aline-vernier/octo-laser/README.md

octo-laser
==========

Compression Chamber Design
