aline-vernier/octo-laser/HCF/Tamas Drawings.pdf

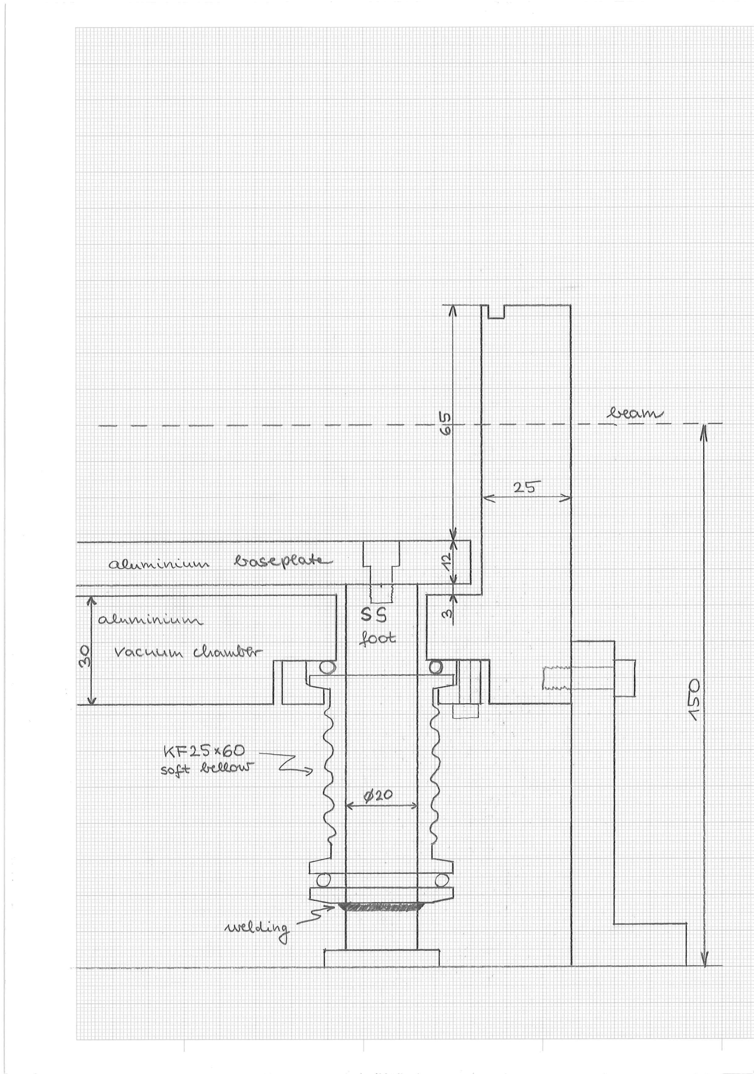
[picture p1: page 1]
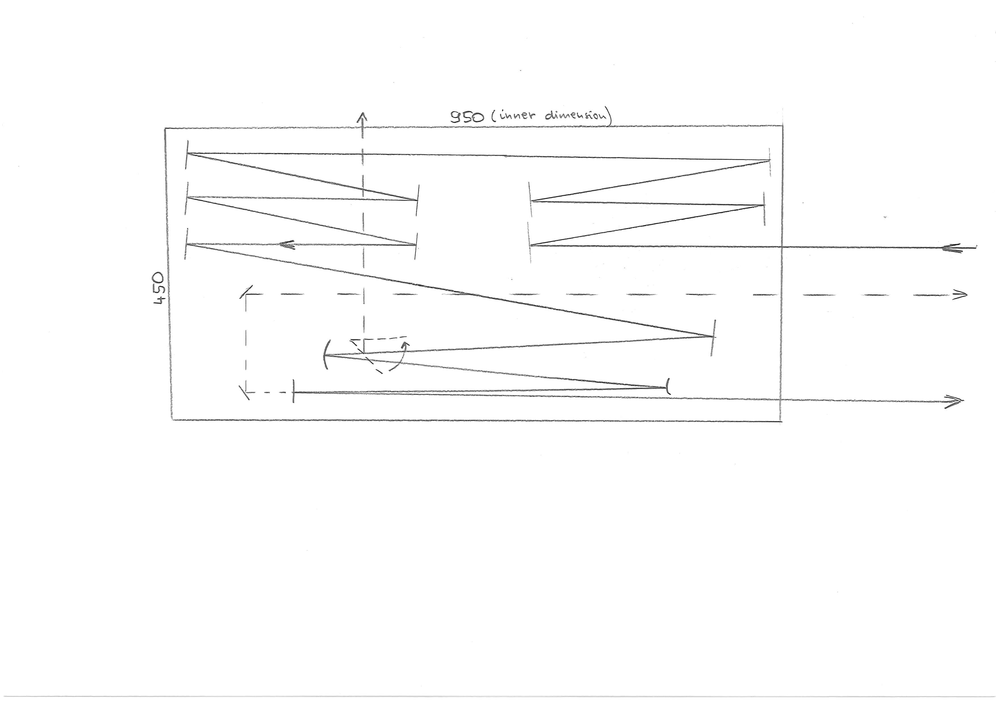
[picture p2: page 2]
