aline-vernier/octo-laser/HCF/Aurelie1.png

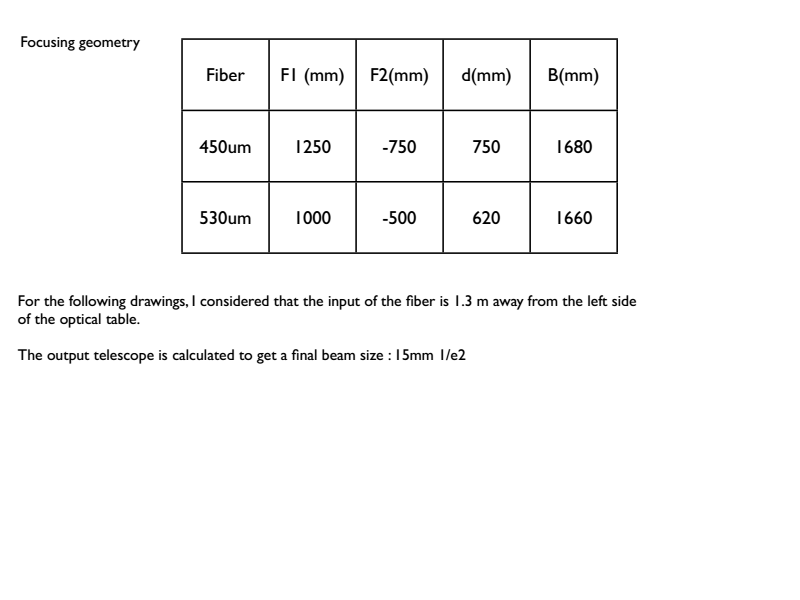
HCF/Aurelie1.png
