aline-vernier/octo-laser/HCF/Aurelie2.png

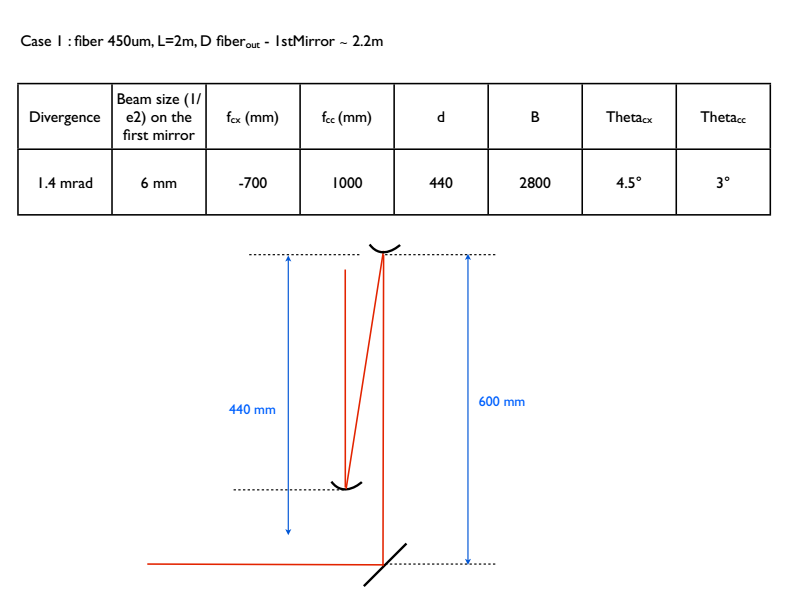
HCF/Aurelie2.png
