aline-vernier/octo-laser/HCF/Aurelie4.png

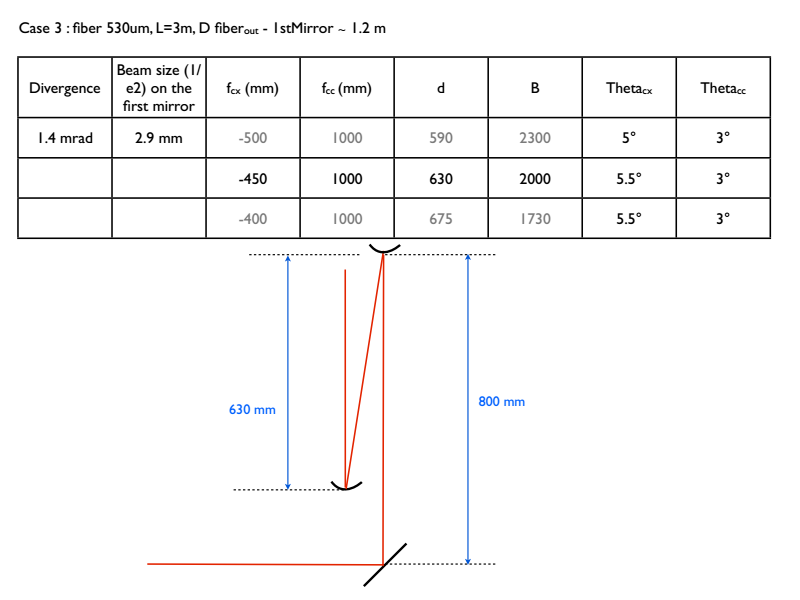
HCF/Aurelie4.png
