aline-vernier/octo-laser/HCF/Table Dimensions.png

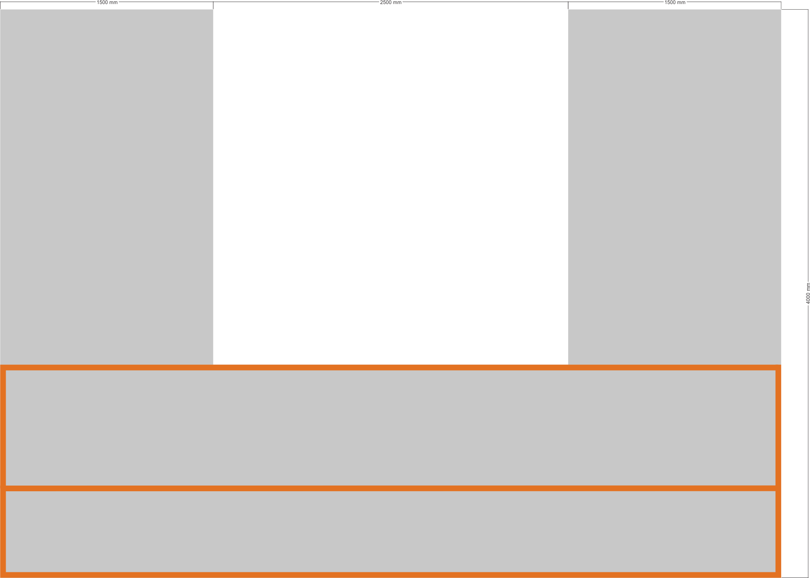
HCF/Table Dimensions.png
