aline-vernier/octo-laser/Mechanical_Electrical parts.rtf

Electrical Feedthroughs:

USB 3
SubD 15 1
SubD 25 4
SubD 9 3? (picomotors)

Machined flanges:

USB x2 + subD 15 x1 DN100
SubD25 Rosace
SubD9 x3 DN100

Brewster window DN100?
FROG window
CEP window
SH window

Motors:

Wedges - 2 motors:
-rotation
-translation
Mirror direction correction pulse-front tilt:
-translation

Picomotors:

HeNe x2
Main Beam x2
Correction beam direction après PFT x2
Correction Prepulse direction x2
