aline-vernier/octo-laser/Purchase List.xlsx

Description | Comment | Quantity | Distributor | Status
Periscope |  |  |  | Design not started
Periscope Main Beam |  |  |  | ?
Ground Plate for CMs |  |  |  | ?
Holed Mirror Translation | Frederik | 1 |  | Greg will do a design FB
Mount for 'Swiss Cheese' mirror | Aline | 1 |  | Designed, CAD in progress at Greg's
Plate for chirped mirrors |  |  |  | ?
Filter ( Lanex) |  | 1 |  | Found
TL Silver Mirror 3" |  | 4 | direct | ?
TL Silver Mirror 2" |  | 4 | direct | ?
TL Silver Mirror 1" |  | 4 | direct | Received 01/03/2015 FB
Mount 3" |  | Verify stock + check with Benoit for what has already been ordered | Newport | ?
Femtolasers Silver Mirror 1.5" |  | 4 | BFI | Ordered 01/03/2015 FB
1.5" mirror mounts |  | 4 | ? | ?
Window Flange |  | Verify stock |  | ?
Shack-Hartmann windows |  |  |  | Received (16/04/2015), Aurélie
Ceramic Plates | Beamblocking | 10 |  | Received glass diffusers OK? FB
Translation/flip for Beam block |  | 1 |  | Not designed
Pico Mount 3" | Compatible for our vacuum | 1 |  | Ordered 12/03/2015
Pico Mount 1" | Compatible for our vacuum | 1 |  | 2" Ordered 12/03/2015
ISO-K Tee + 2 Flanges | ISO 160 - | 1 |  | Received - Machining in progress
Vacuum-compatible subd 15 cable | 3 metres | 1 |  | Ordered on 29/01/2015, where is it?? To be reordered?
Shutter connector | Do we have everything? |  |  | Not done
Conformité ligne PI | Is the performance of the translation stage up to specs? |  |  | Not done
Add wedge to attenuator design |  |  |  | ok
New attenuator design test |  |  |  | ok, 160µrad PV over 4cm
2" Wedges for measurement |  |  |  | Ordered on 24/02/2015 (Aurélie)
More 3" Femtolaser/Layertec mirrors? |  |  |  | ?
99% transmission mirrors for far-field? (2") |  |  |  | ?
How many Newport flips + controllers do we have? |  |  |  | ?
Standalone picomotors to put on SH mirror x2 |  | 2 + controller |  | Not ordered
Feedthroughs for delay line (subd15 + HD subd15?) |  |  |  | Subd15 ok HD to be ordered
