aline-vernier/octo-laser/Shutter.FCStd

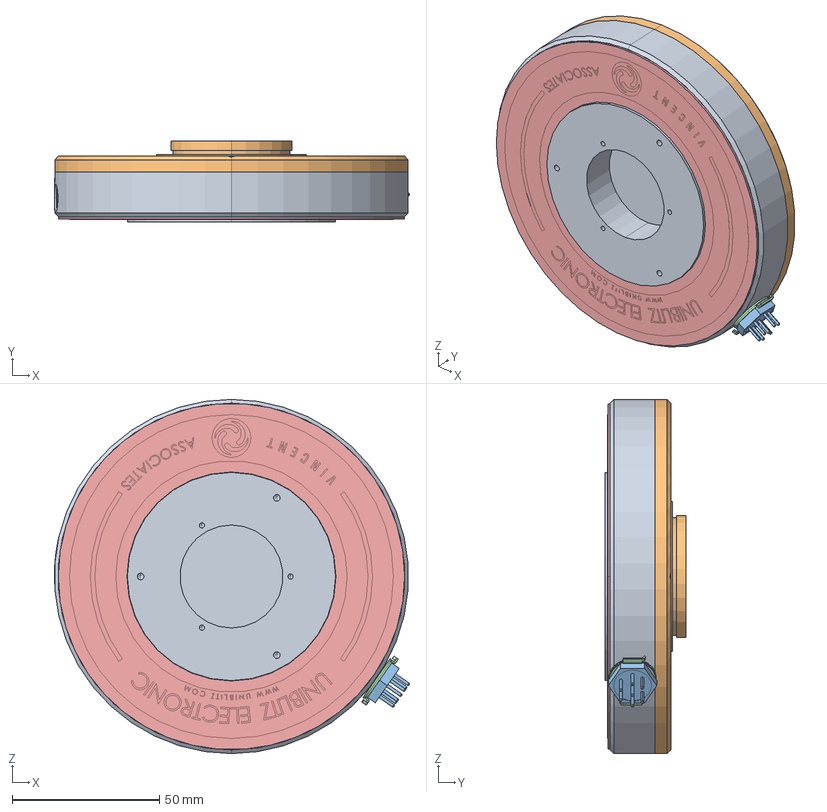
[picture p7: CAD file, 2014-10-17, last stored version]
Shutter.FCStd
120.4 x 27.3 x 120.1 mm
VS35 HOUSE dumb
VS35 HOUSE dumb001
VS35 HOUSE dumb002
VS35 HOUSE dumb003
VS35 HOUSE dumb004
VS35 HOUSE dumb005
VS35 HOUSE dumb006
VS35 HOUSE dumb007
VS35 HOUSE dumb008
