aline-vernier/octo-laser/ILAO40.stp

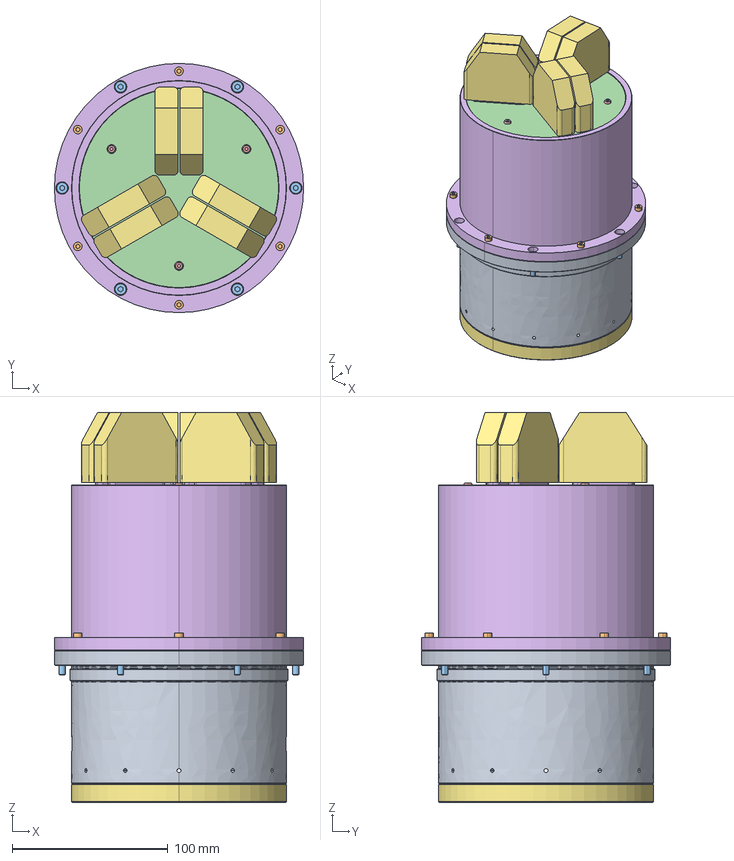
[picture p8: CAD file, 2014-10-06, last stored version]
ILAO40.stp
160.0 x 160.0 x 250.4 mm
VIS_CHC_M2-5_6 x 6
VIS_CHC_M3_12 x 6
VIS_CHC_M3_16 x 6
VIS_CHC_M4_16 x 6
OUTILLAGE_VISSAGE_ASM
VIS_CBC_M3_8 x 3
SUBD25 x 6
