aline-vernier/octo-laser/Salle Noire 2.1.pdf

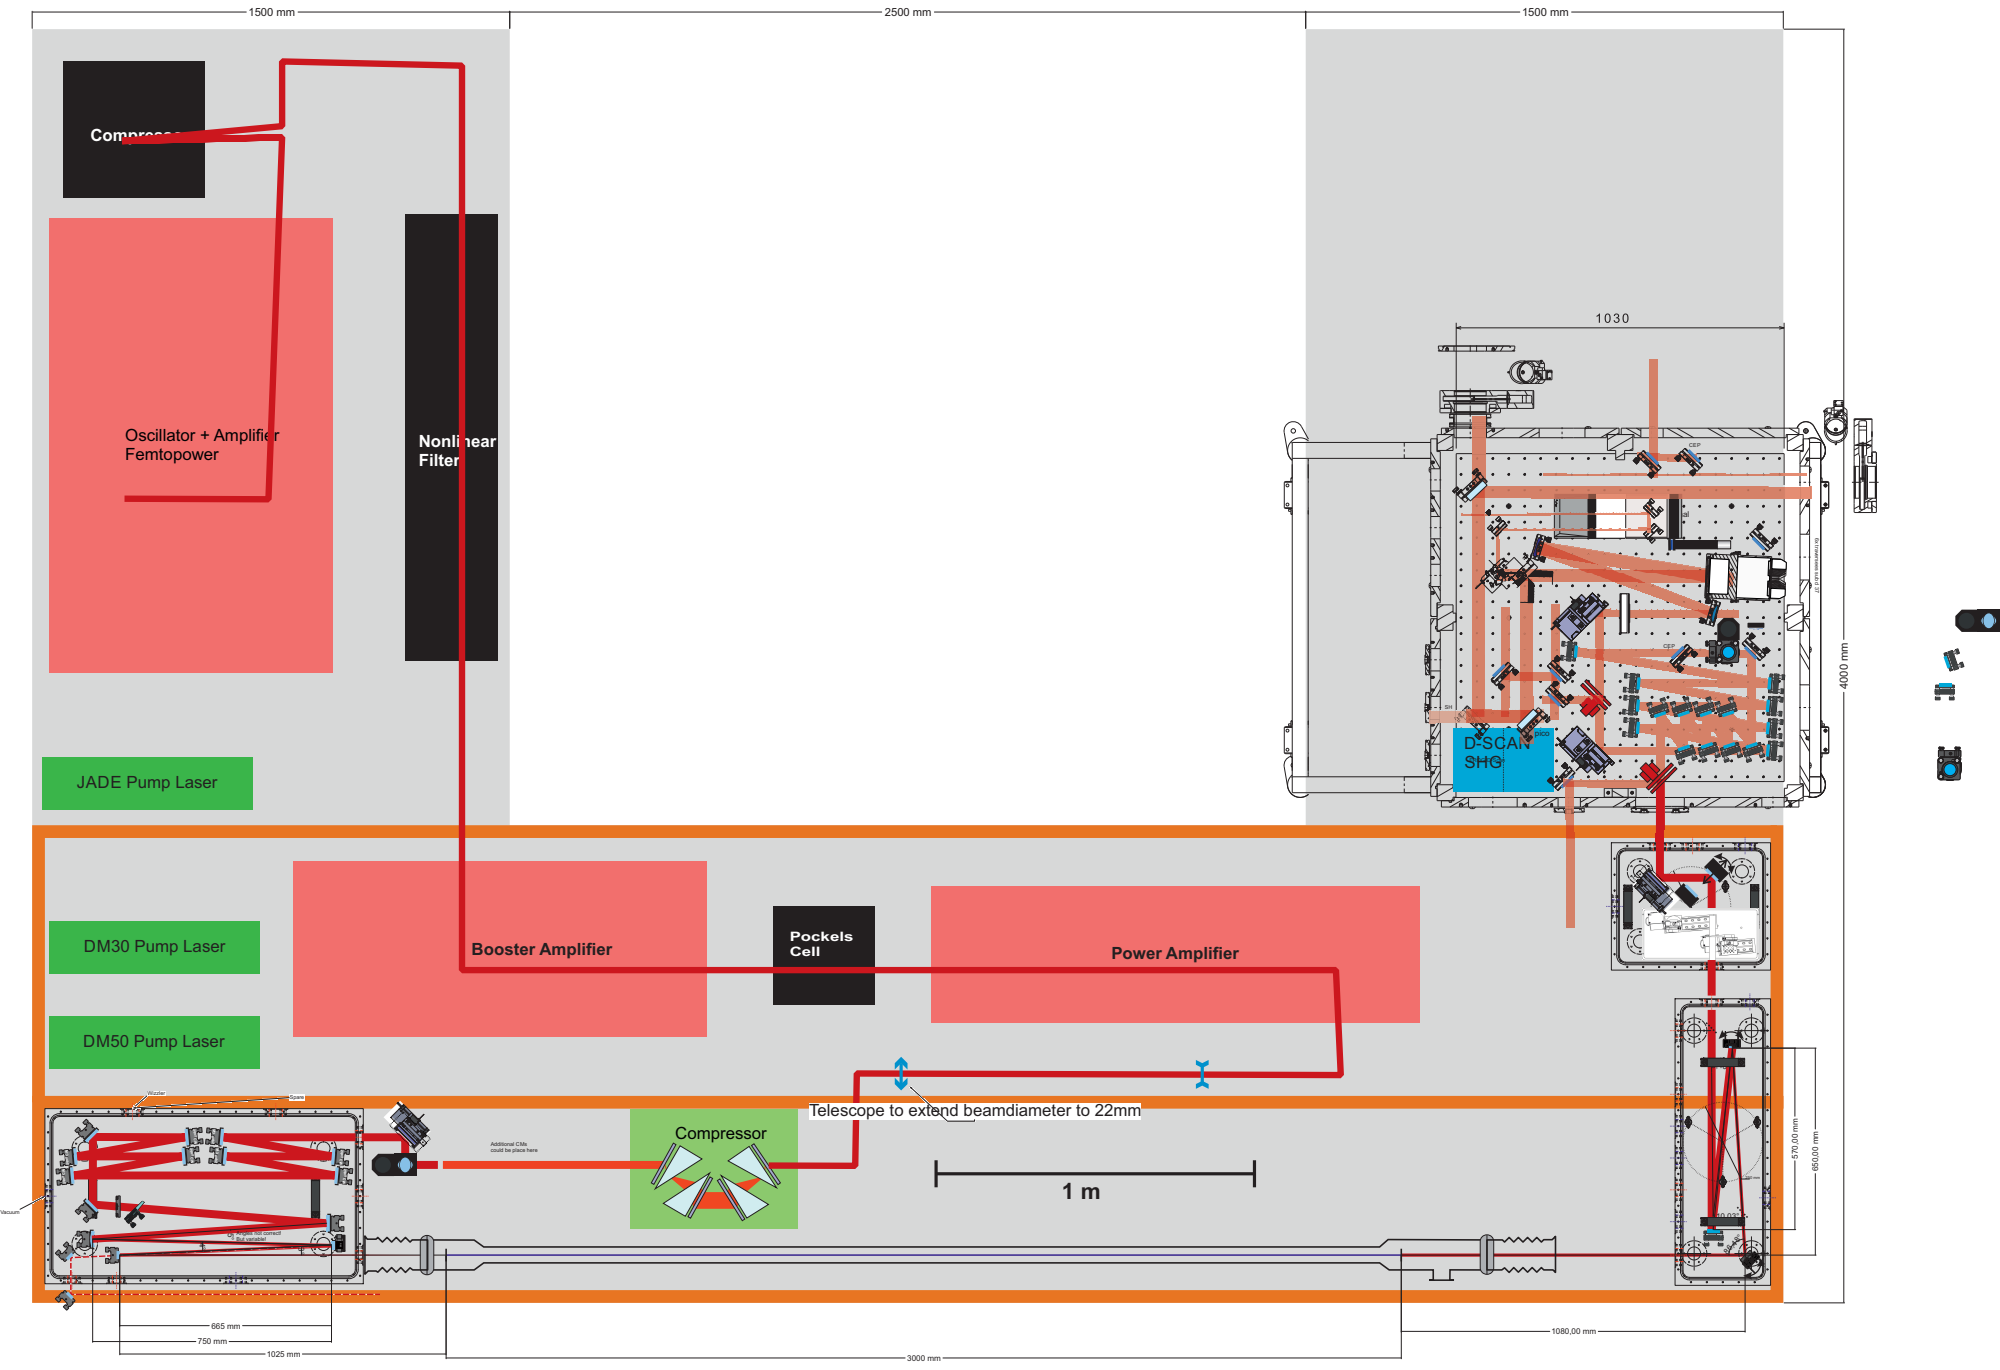
[picture p9: page 1]
Booster Amplifier; DM30 Pump Laser; DM50 Pump Laser; Power Amplifier; Oscillator + Amplifier Femtopower; Compressor; Nonlinear Filter; Pockels Cell; Vacuum; Wizzler; Spare; PIEZ; 5deg CM; 5deg C; D-SCAN SHG; 6x traversees sub d 37; pico; CEP; FROG/D-Scan

Location not final

JADE Pump Laser

Telescope to extend beamdiameter to 22mm

Additional CMs
could be place here

Angles not correct!
But variable!

555,00 mm
