aline-vernier/octo-laser/HCF/HCF Chambers Tamas/InputChamber-LOA_p2.pdf

A ( 1:2 )

A

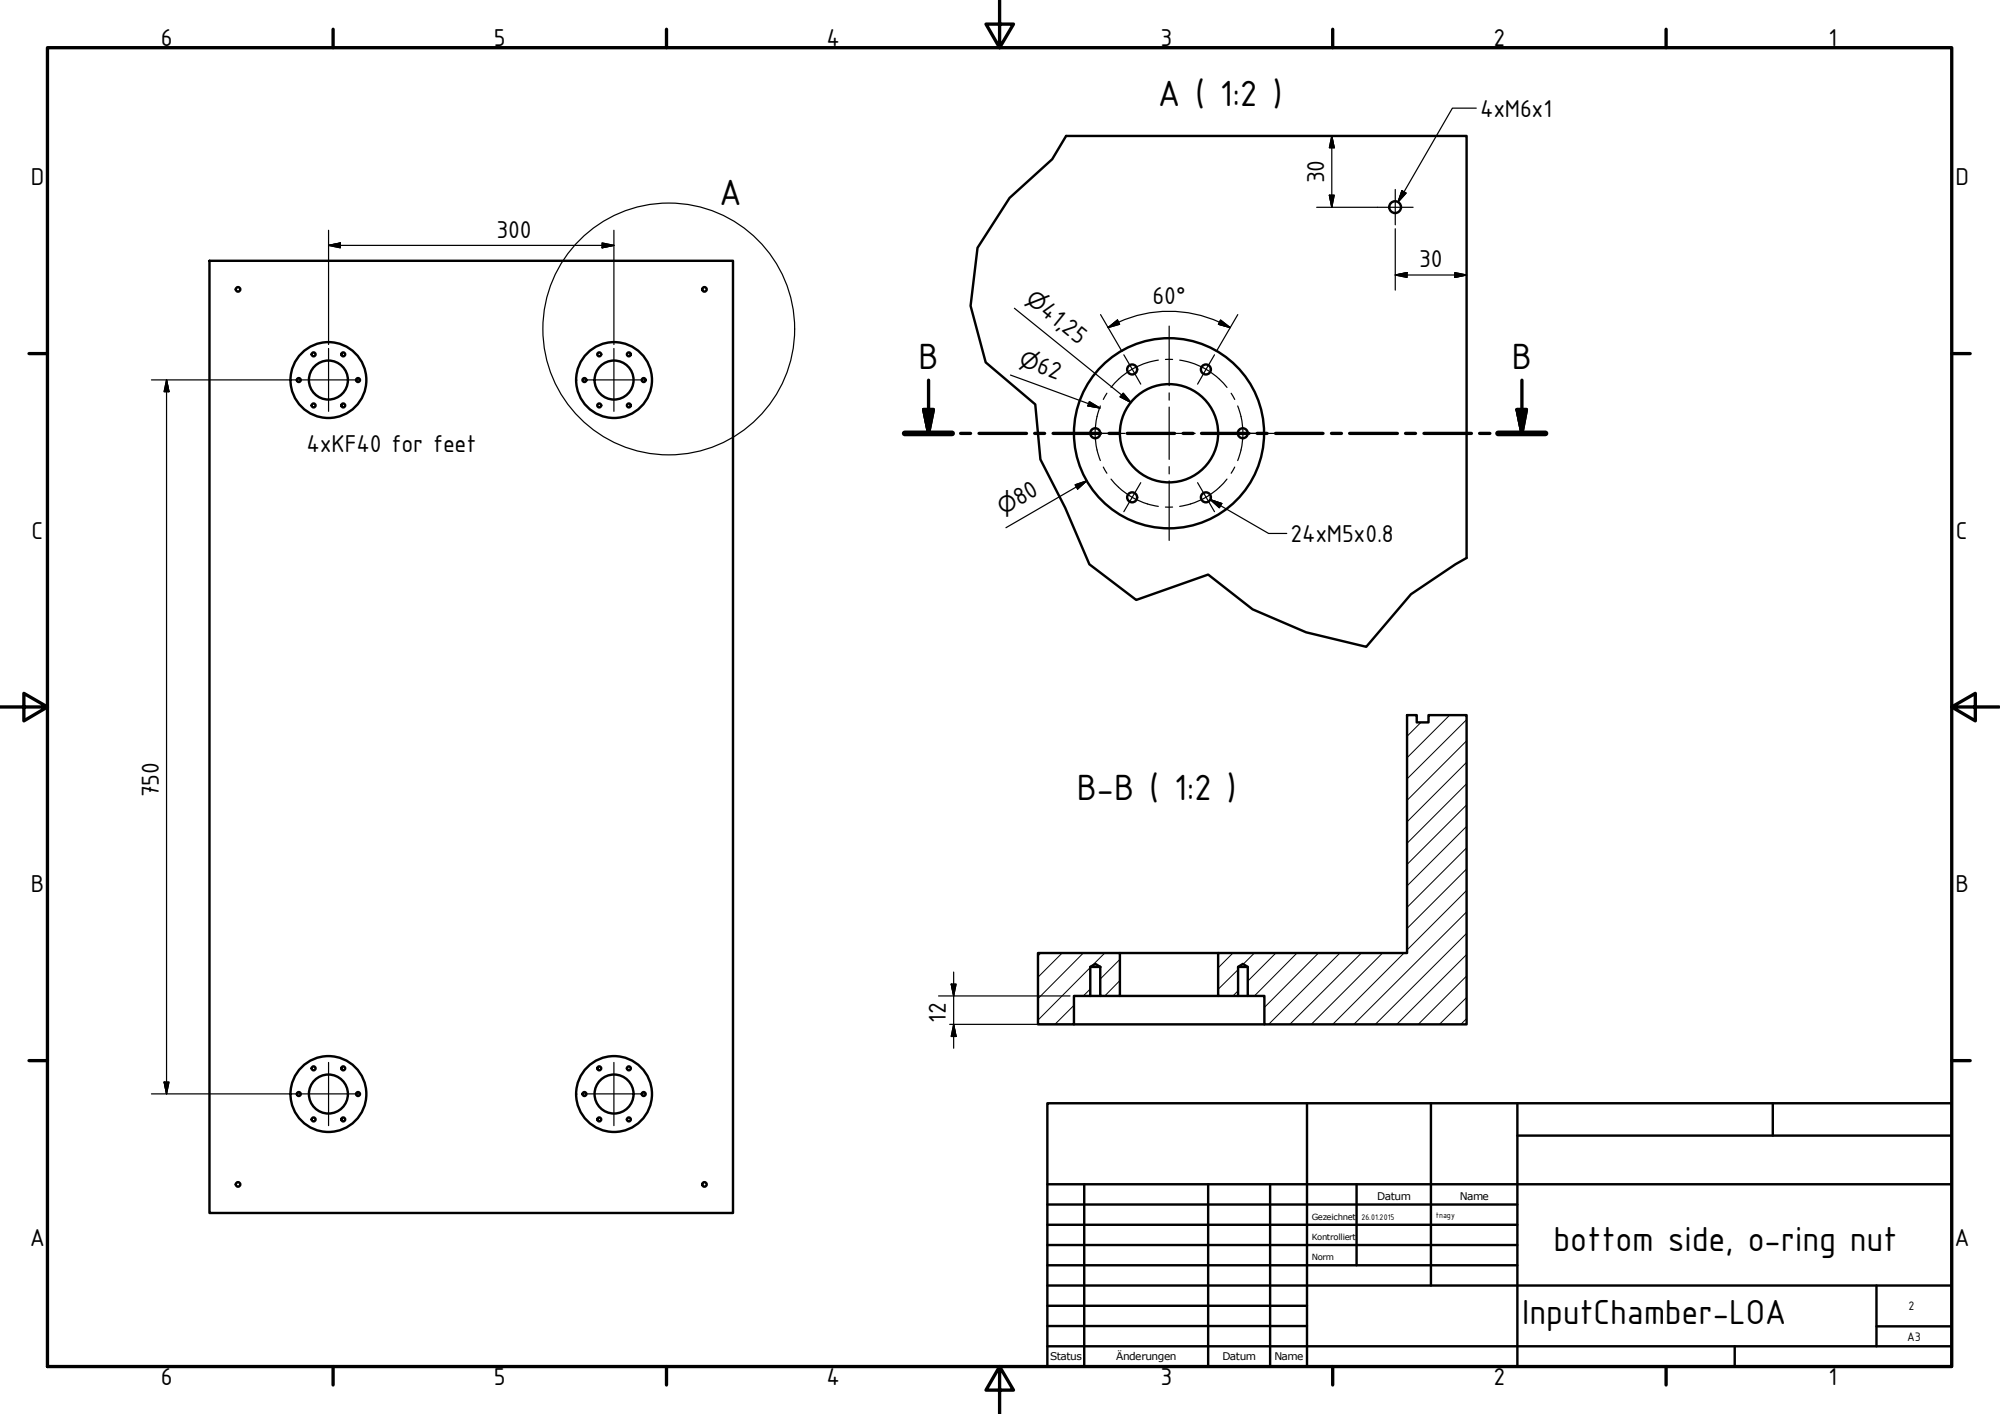
[picture p10: page 1]
InputChamber-LOA; Status; bnderungen; Datum; Name; Gezeichnet; Kontrolliert; Norm; tnagy; 4xKF40 for feet

bottom side, o-ring nut
