aline-vernier/octo-laser/HCF/HCF Chambers Tamas/OutputChamber-LOA.pdf

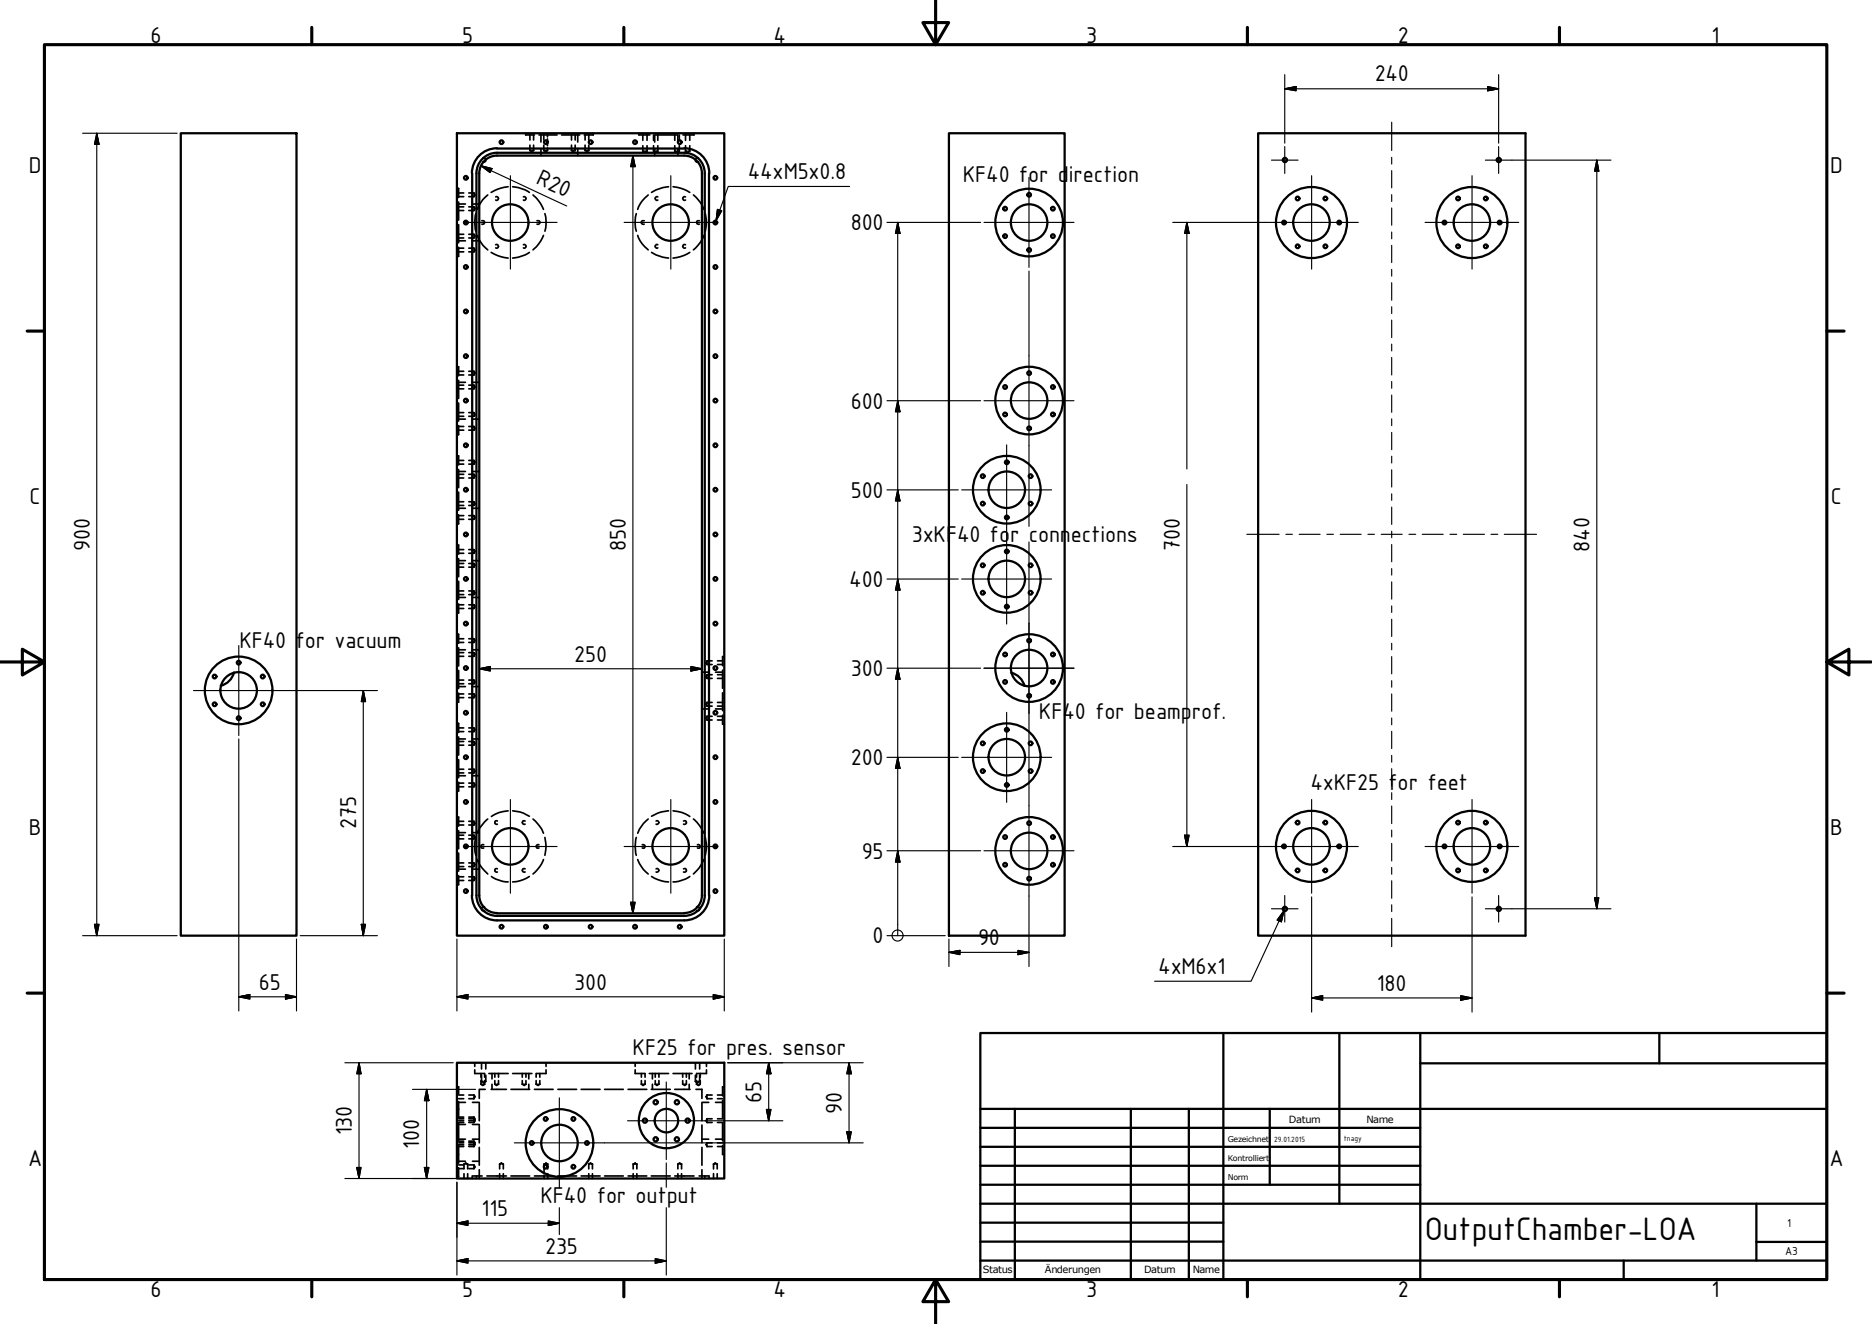
[picture p11: page 1]
OutputChamber-LOA; Status; bnderungen; Datum; Name; Gezeichnet; Kontrolliert; Norm; tnagy; 4xKF25 for feet; KF40 for direction; KF40 for vacuum; KF40 for output; 3xKF40 for connections; KF40 for beamprof.

KF25 for pres. sensor
