aline-vernier/octo-laser/HCF/HCF Chambers Tamas/BasePlate-DScanChamber-LOA.pdf

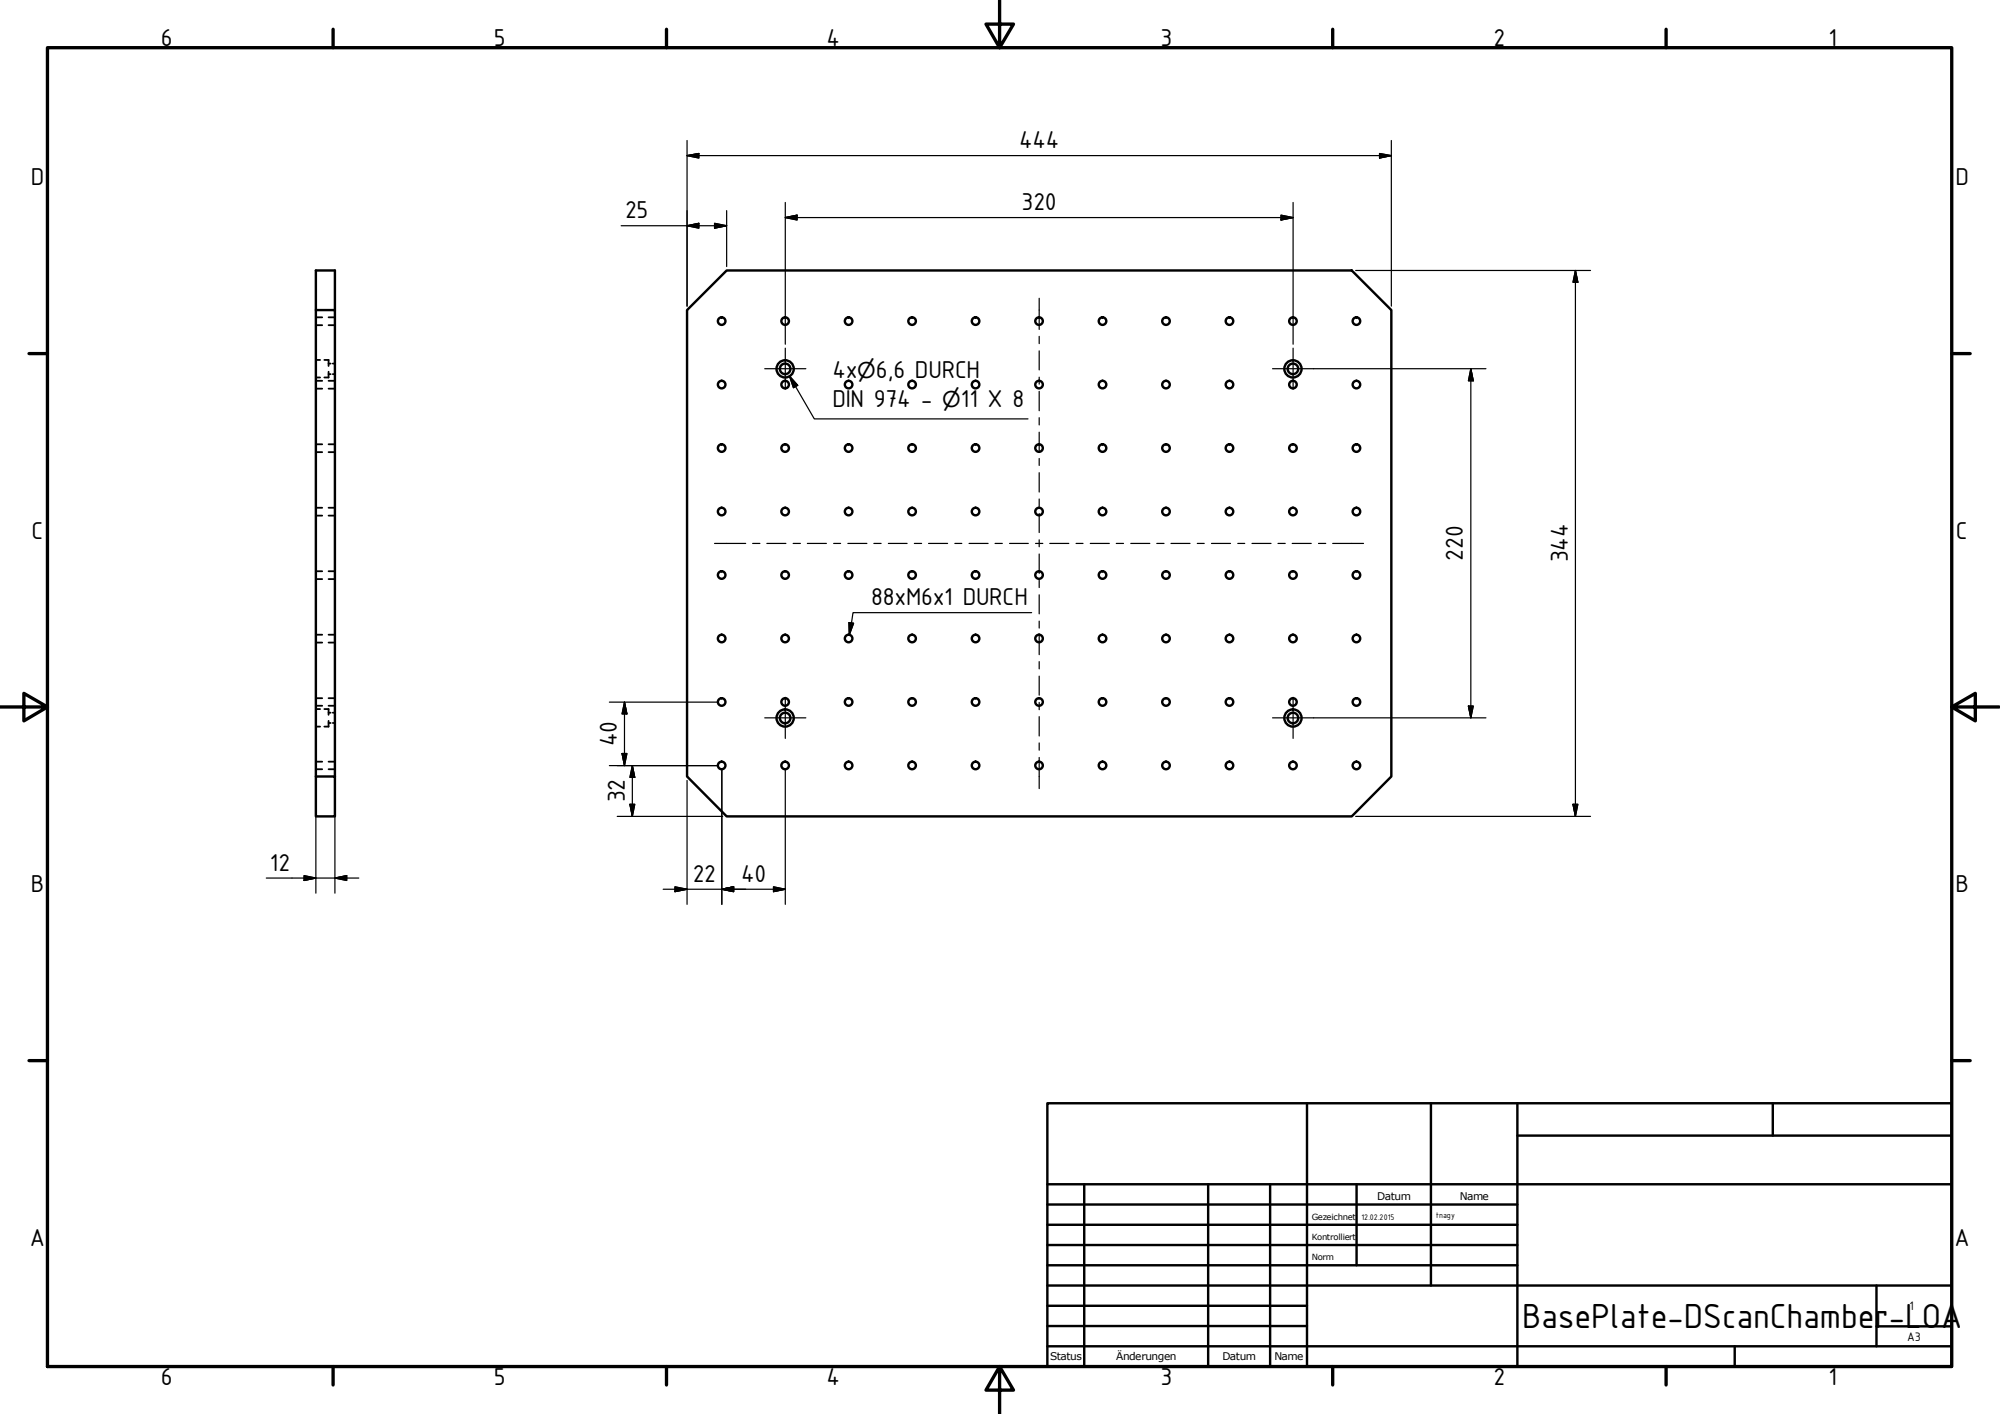
[picture p12: page 1]
Status; bnderungen; Datum; Name; Gezeichnet; Kontrolliert; Norm; tnagy; 88xM6x1 DURCH; 4xP6,6 DURCH DIN 974 - P11 X 8

BasePlate-DScanChamber-LOA
