aline-vernier/octo-laser/HCF/HCF Chambers Tamas/BasePlate-InputChamber-LOA.pdf

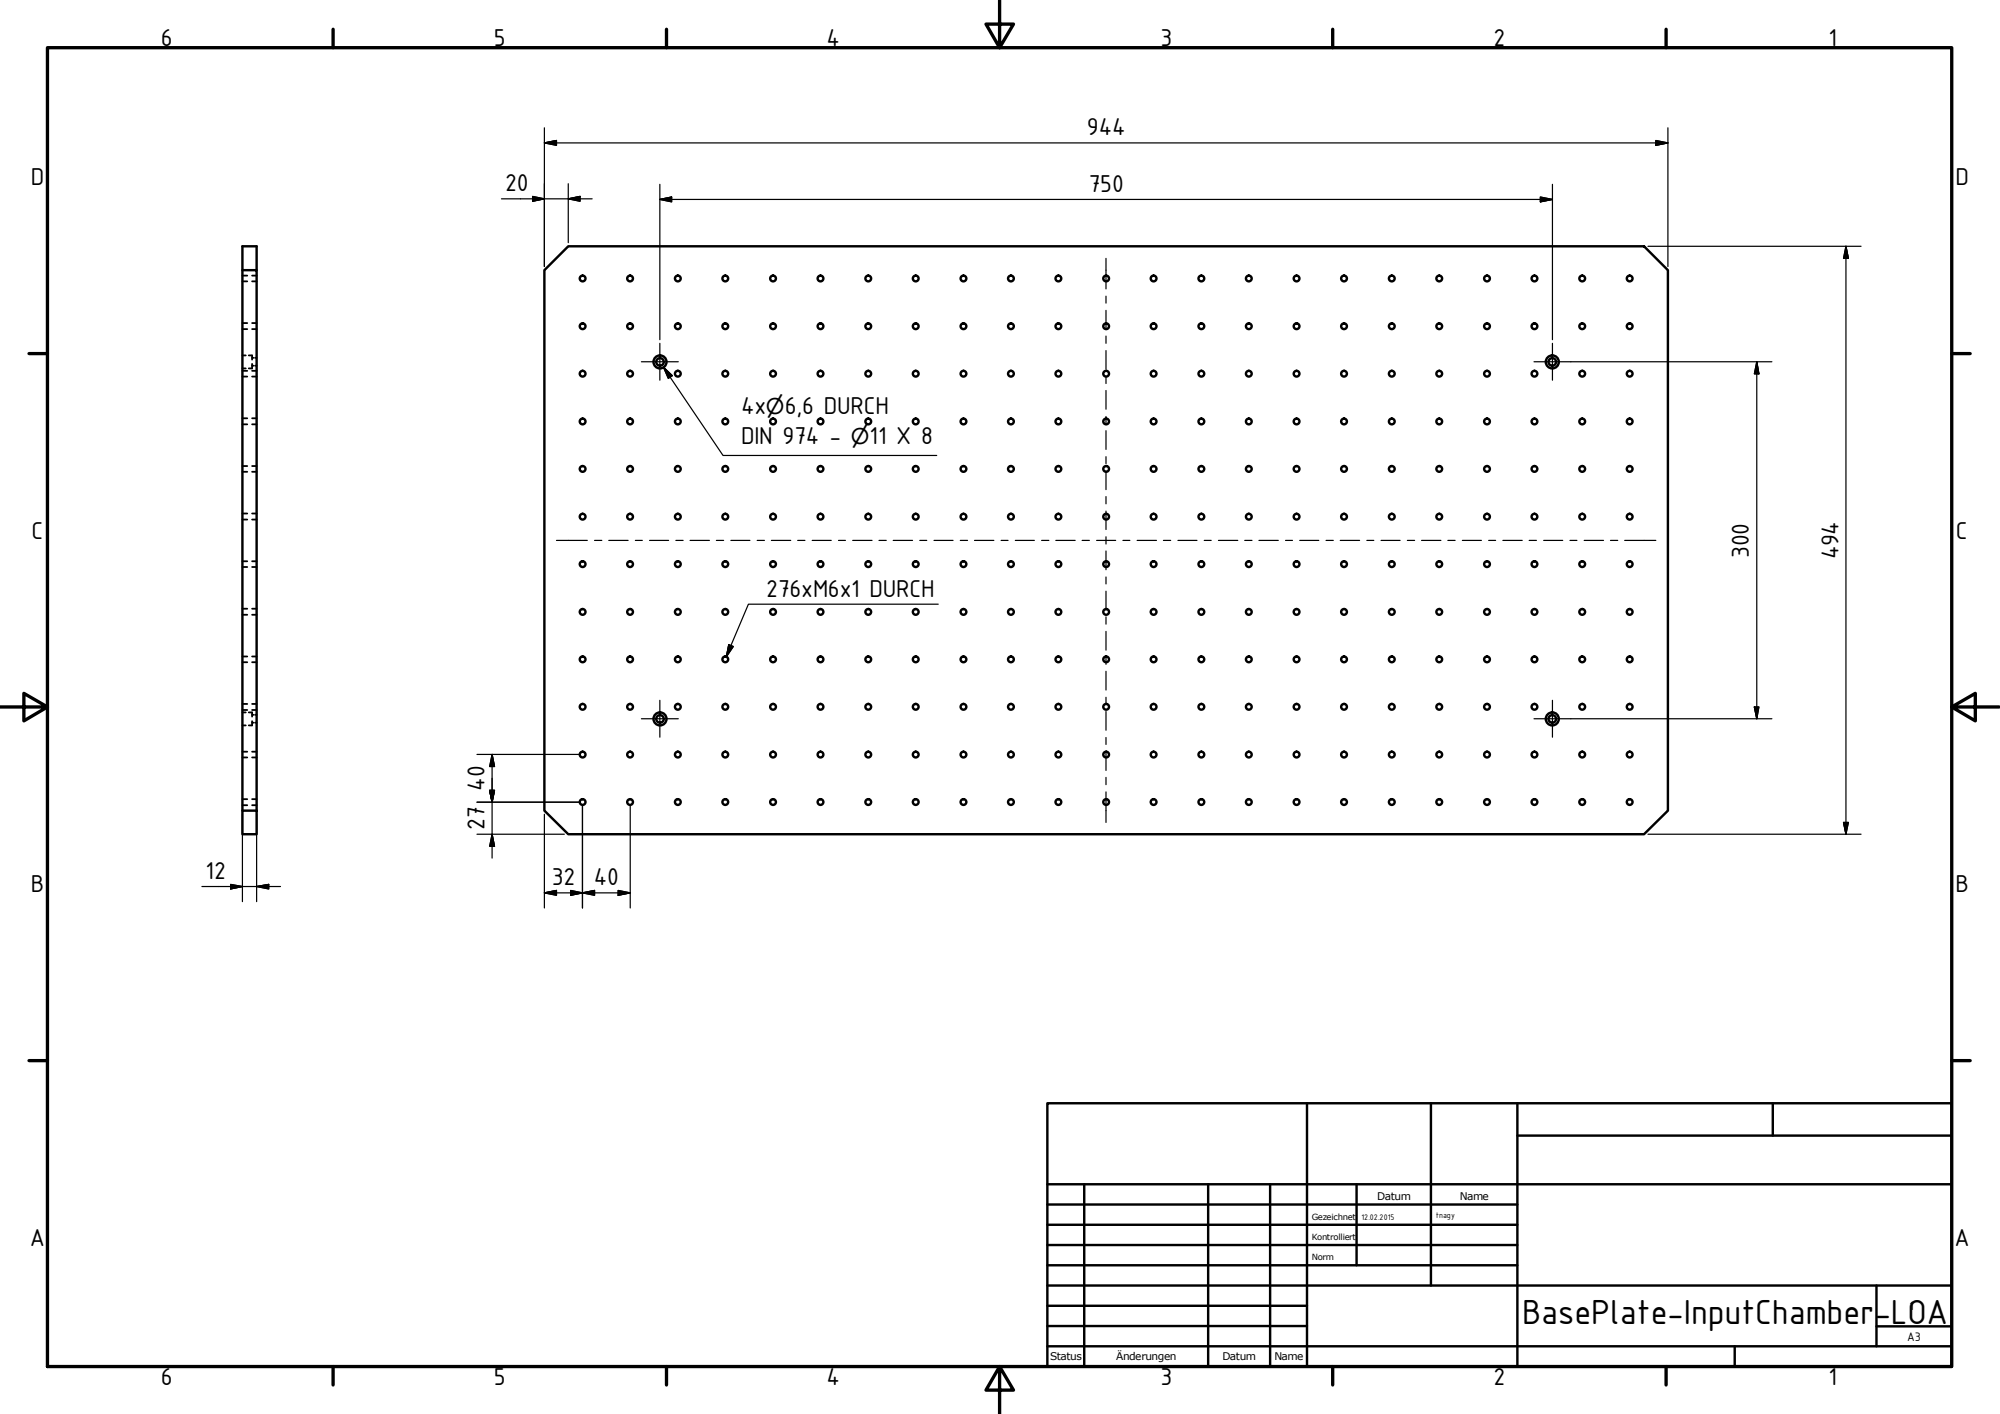
[picture p13: page 1]
Status; bnderungen; Datum; Name; Gezeichnet; Kontrolliert; Norm; tnagy; 4xP6,6 DURCH DIN 974 - P11 X 8; 276xM6x1 DURCH

BasePlate-InputChamber-LOA
