aline-vernier/octo-laser/HCF/HCF Chambers Tamas/BasePlate-OutputChamber-LOA.pdf

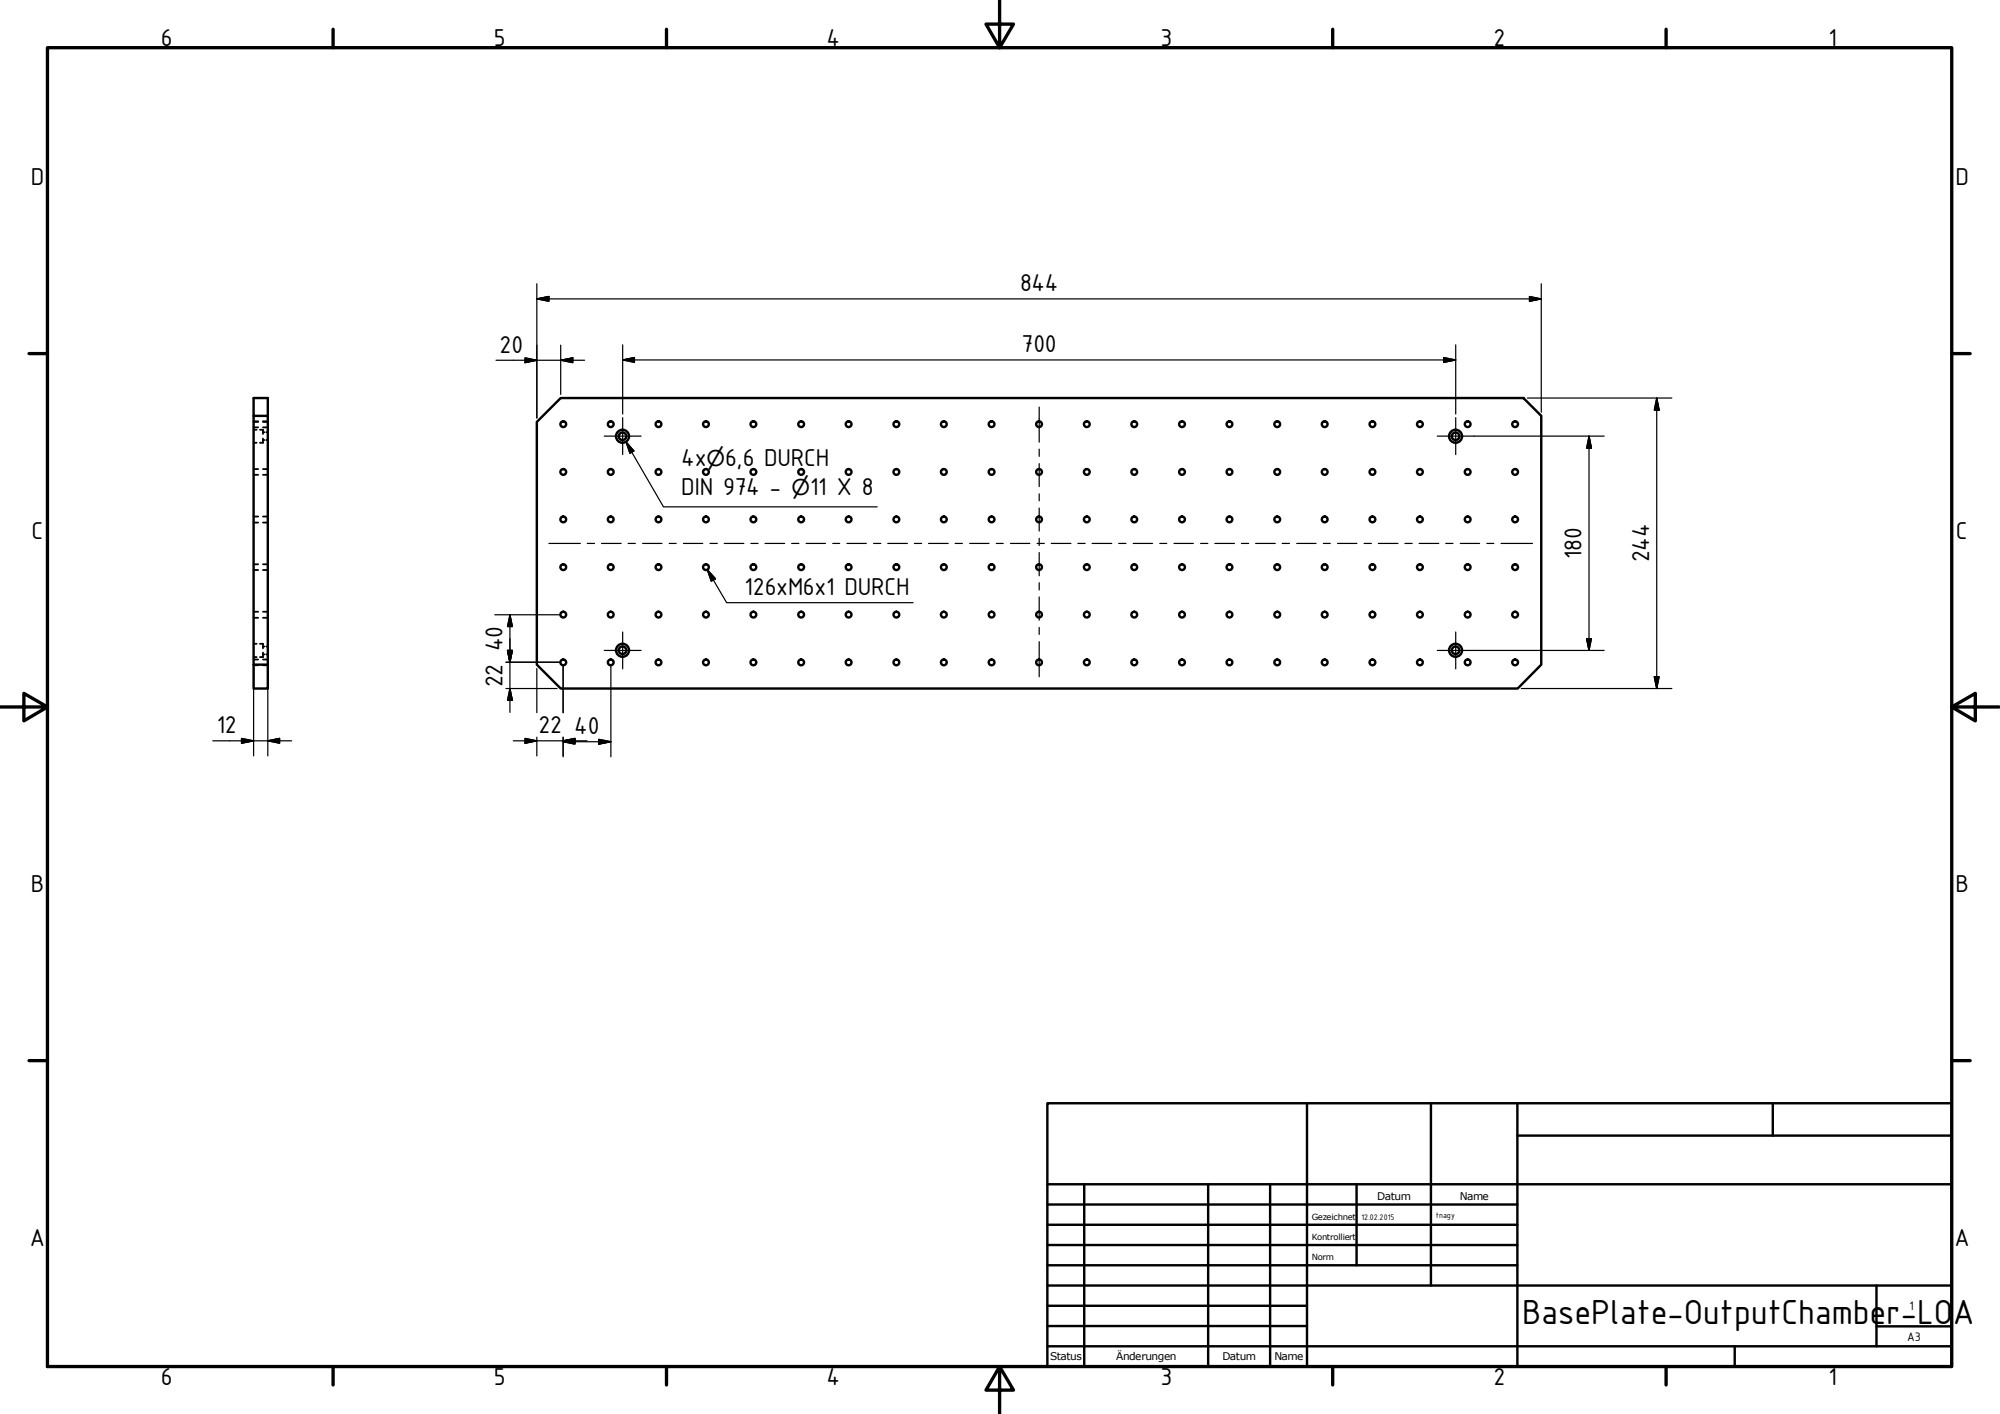
[picture p14: page 1]
Status; bnderungen; Datum; Name; Gezeichnet; Kontrolliert; Norm; tnagy; 126xM6x1 DURCH; 4xP6,6 DURCH DIN 974 - P11 X 8

BasePlate-OutputChamber-LOA
