aline-vernier/octo-laser/HCF/HCF Chambers Tamas/Cover-DScanChamber-LOA.pdf

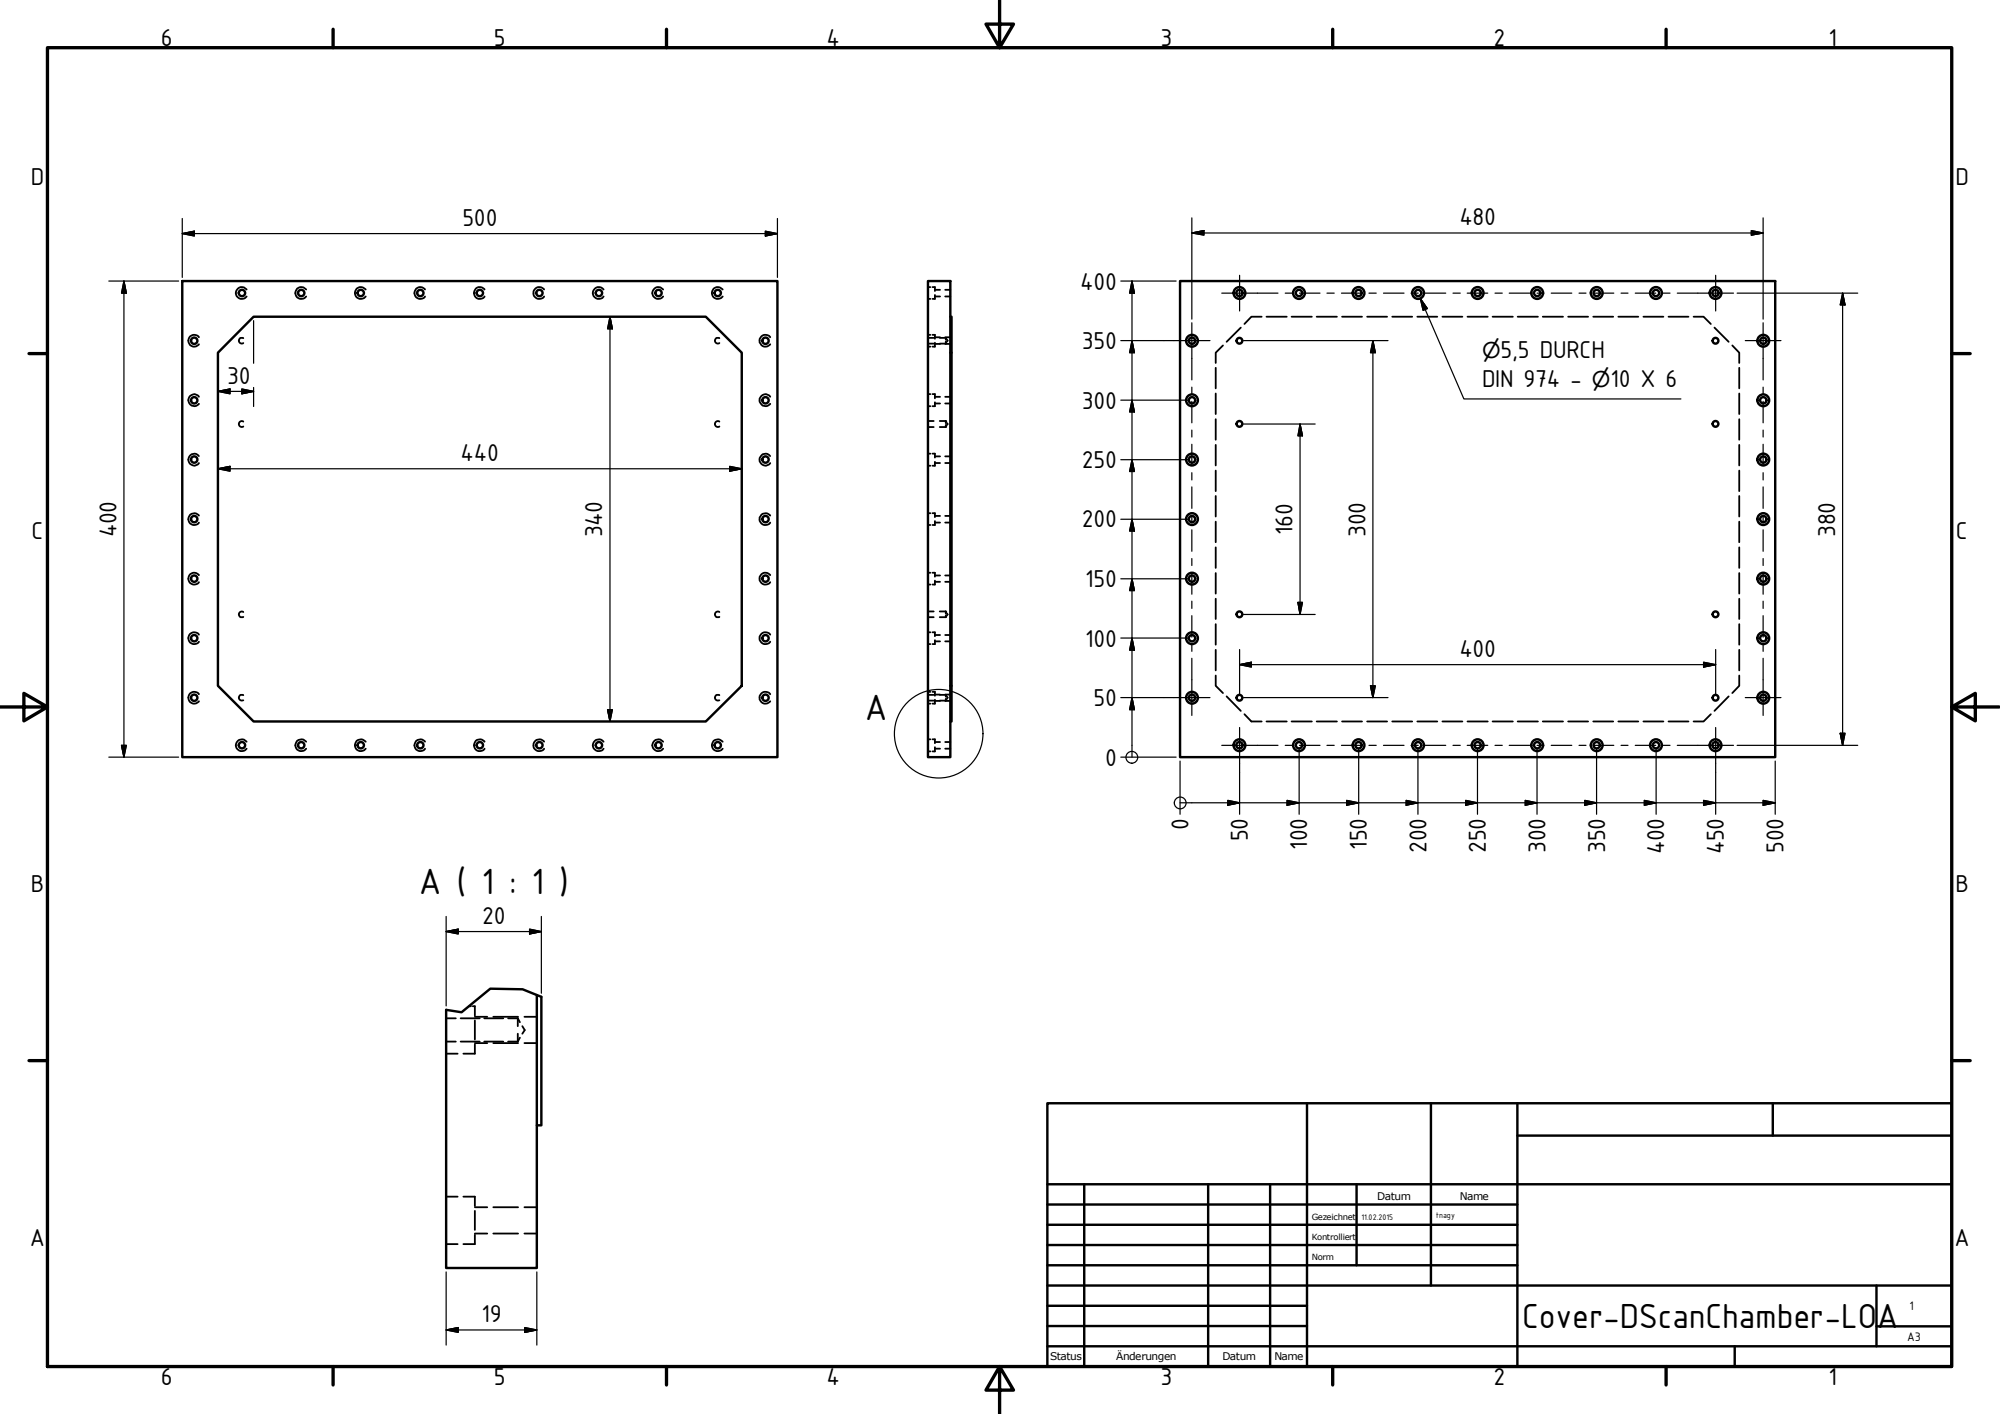
[picture p15: page 1]
Status; bnderungen; Datum; Name; Gezeichnet; Kontrolliert; Norm; tnagy; P5,5 DURCH DIN 974 - P10 X 6

Cover-DScanChamber-LOA
