aline-vernier/octo-laser/HCF/HCF Chambers Tamas/DScanChamber-LOA.pdf

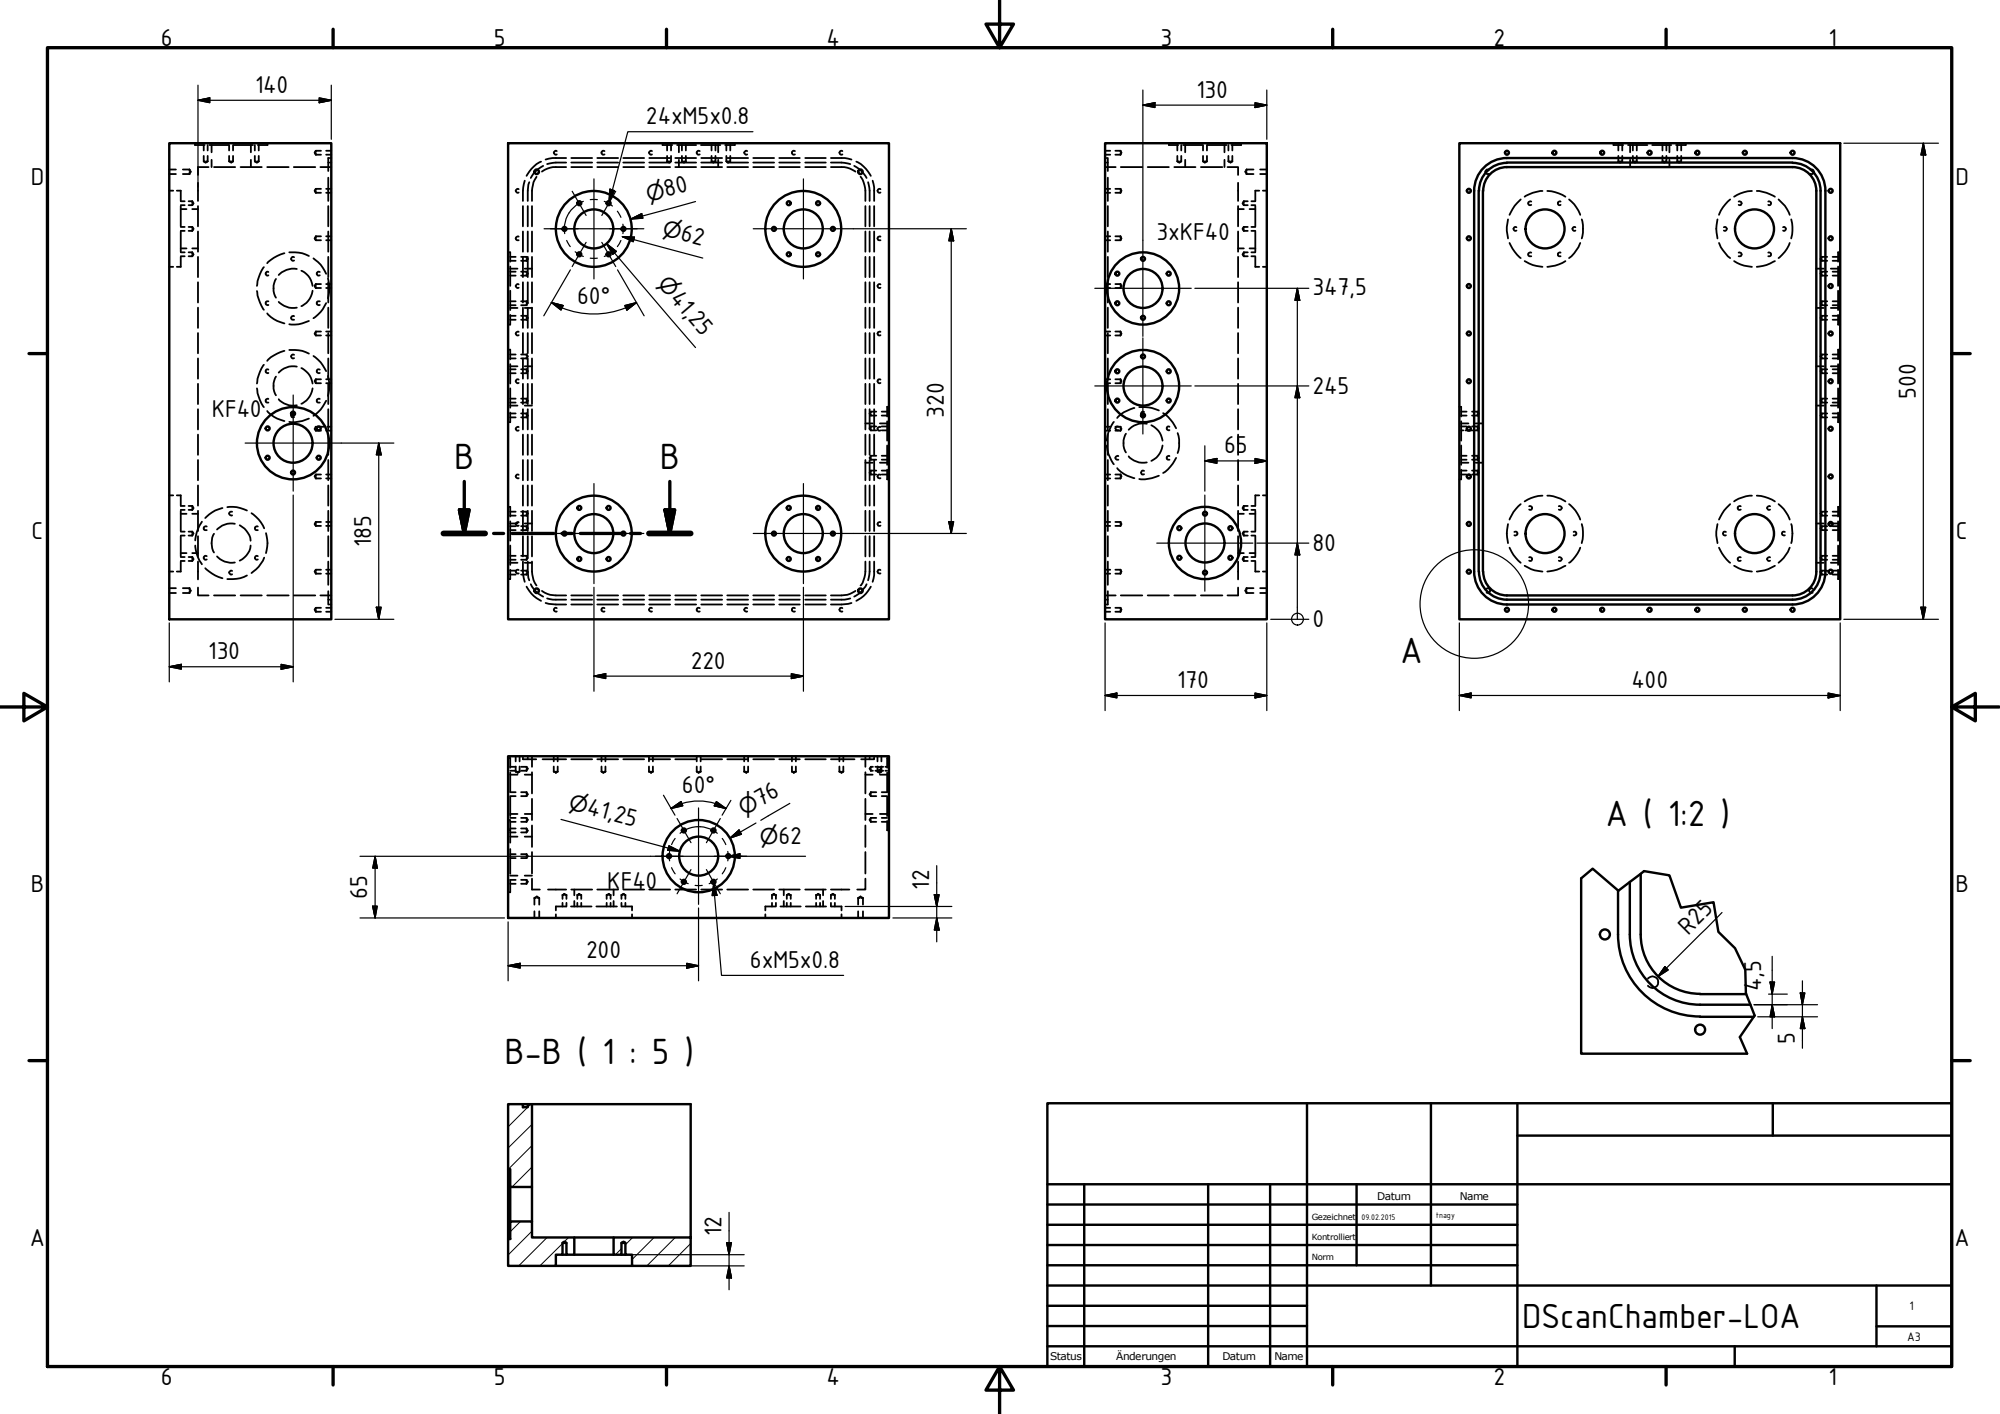
[picture p16: page 1]
DScanChamber-LOA; Status; bnderungen; Datum; Name; Gezeichnet; Kontrolliert; Norm; tnagy; 3xKF40
