aline-vernier/octo-laser/HCF/HCF Chambers Tamas/InputChamber-LOA_p1.pdf

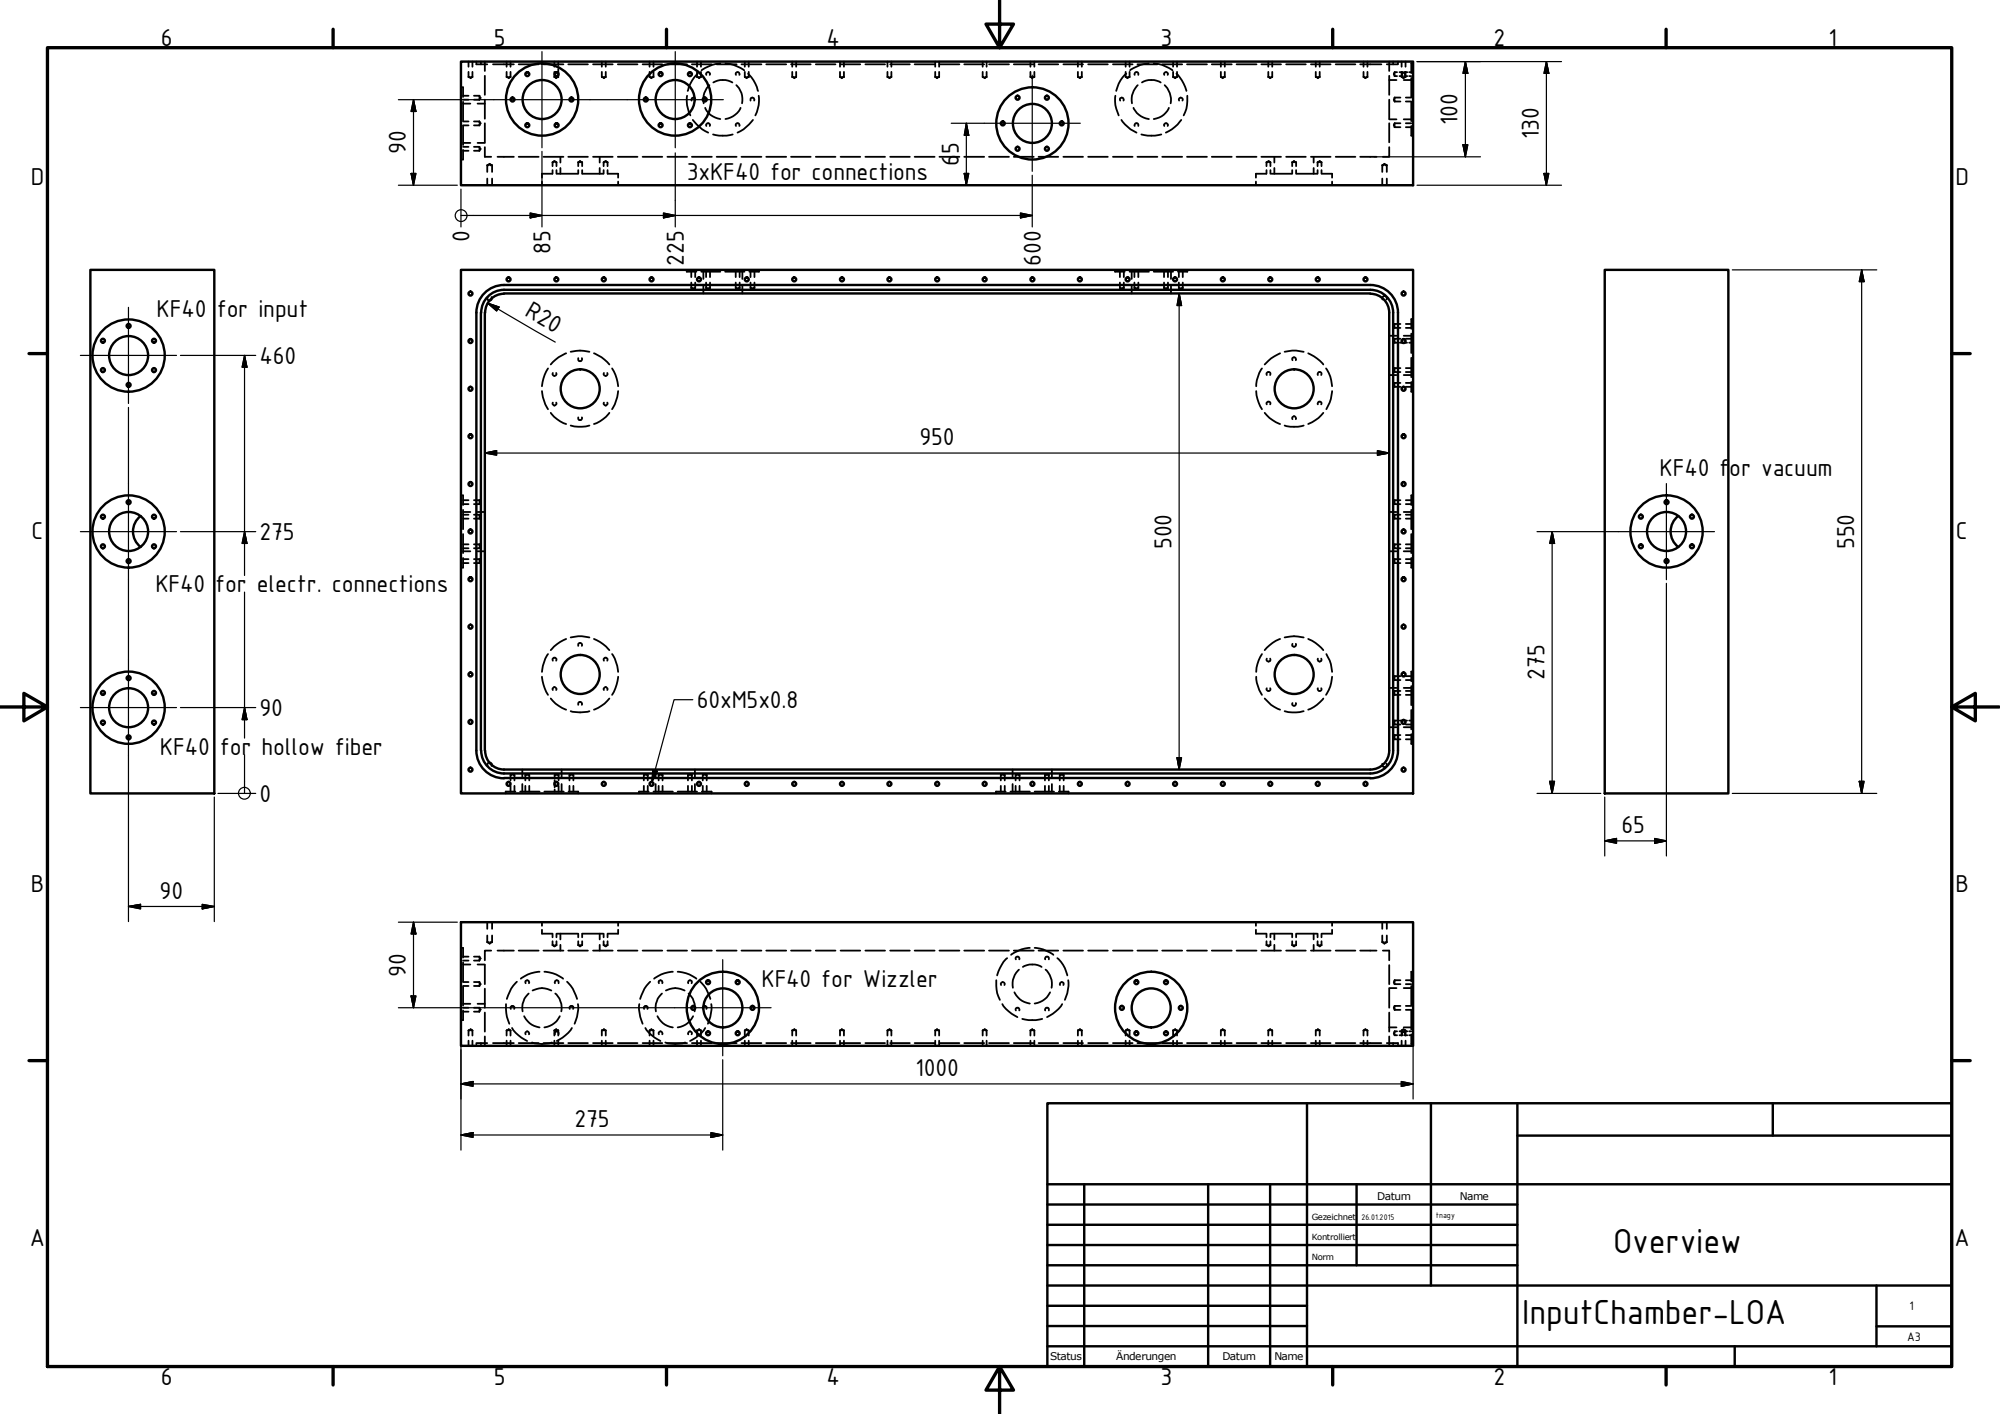
[picture p17: page 1]
InputChamber-LOA; Status; bnderungen; Datum; Name; KF40 for input; KF40 for Wizzler; KF40 for vacuum; Overview; 3xKF40 for connections

KF40 for electr. connections

KF40 for hollow fiber

Gezeichnet | 26.01.2015 | tnagy

Kontrolliert

Norm
