aline-vernier/octo-laser/HCF/HCF Chambers Tamas/InputChamber-LOA_p3.pdf

F ( 1:2 )

K-K ( 1:5 )

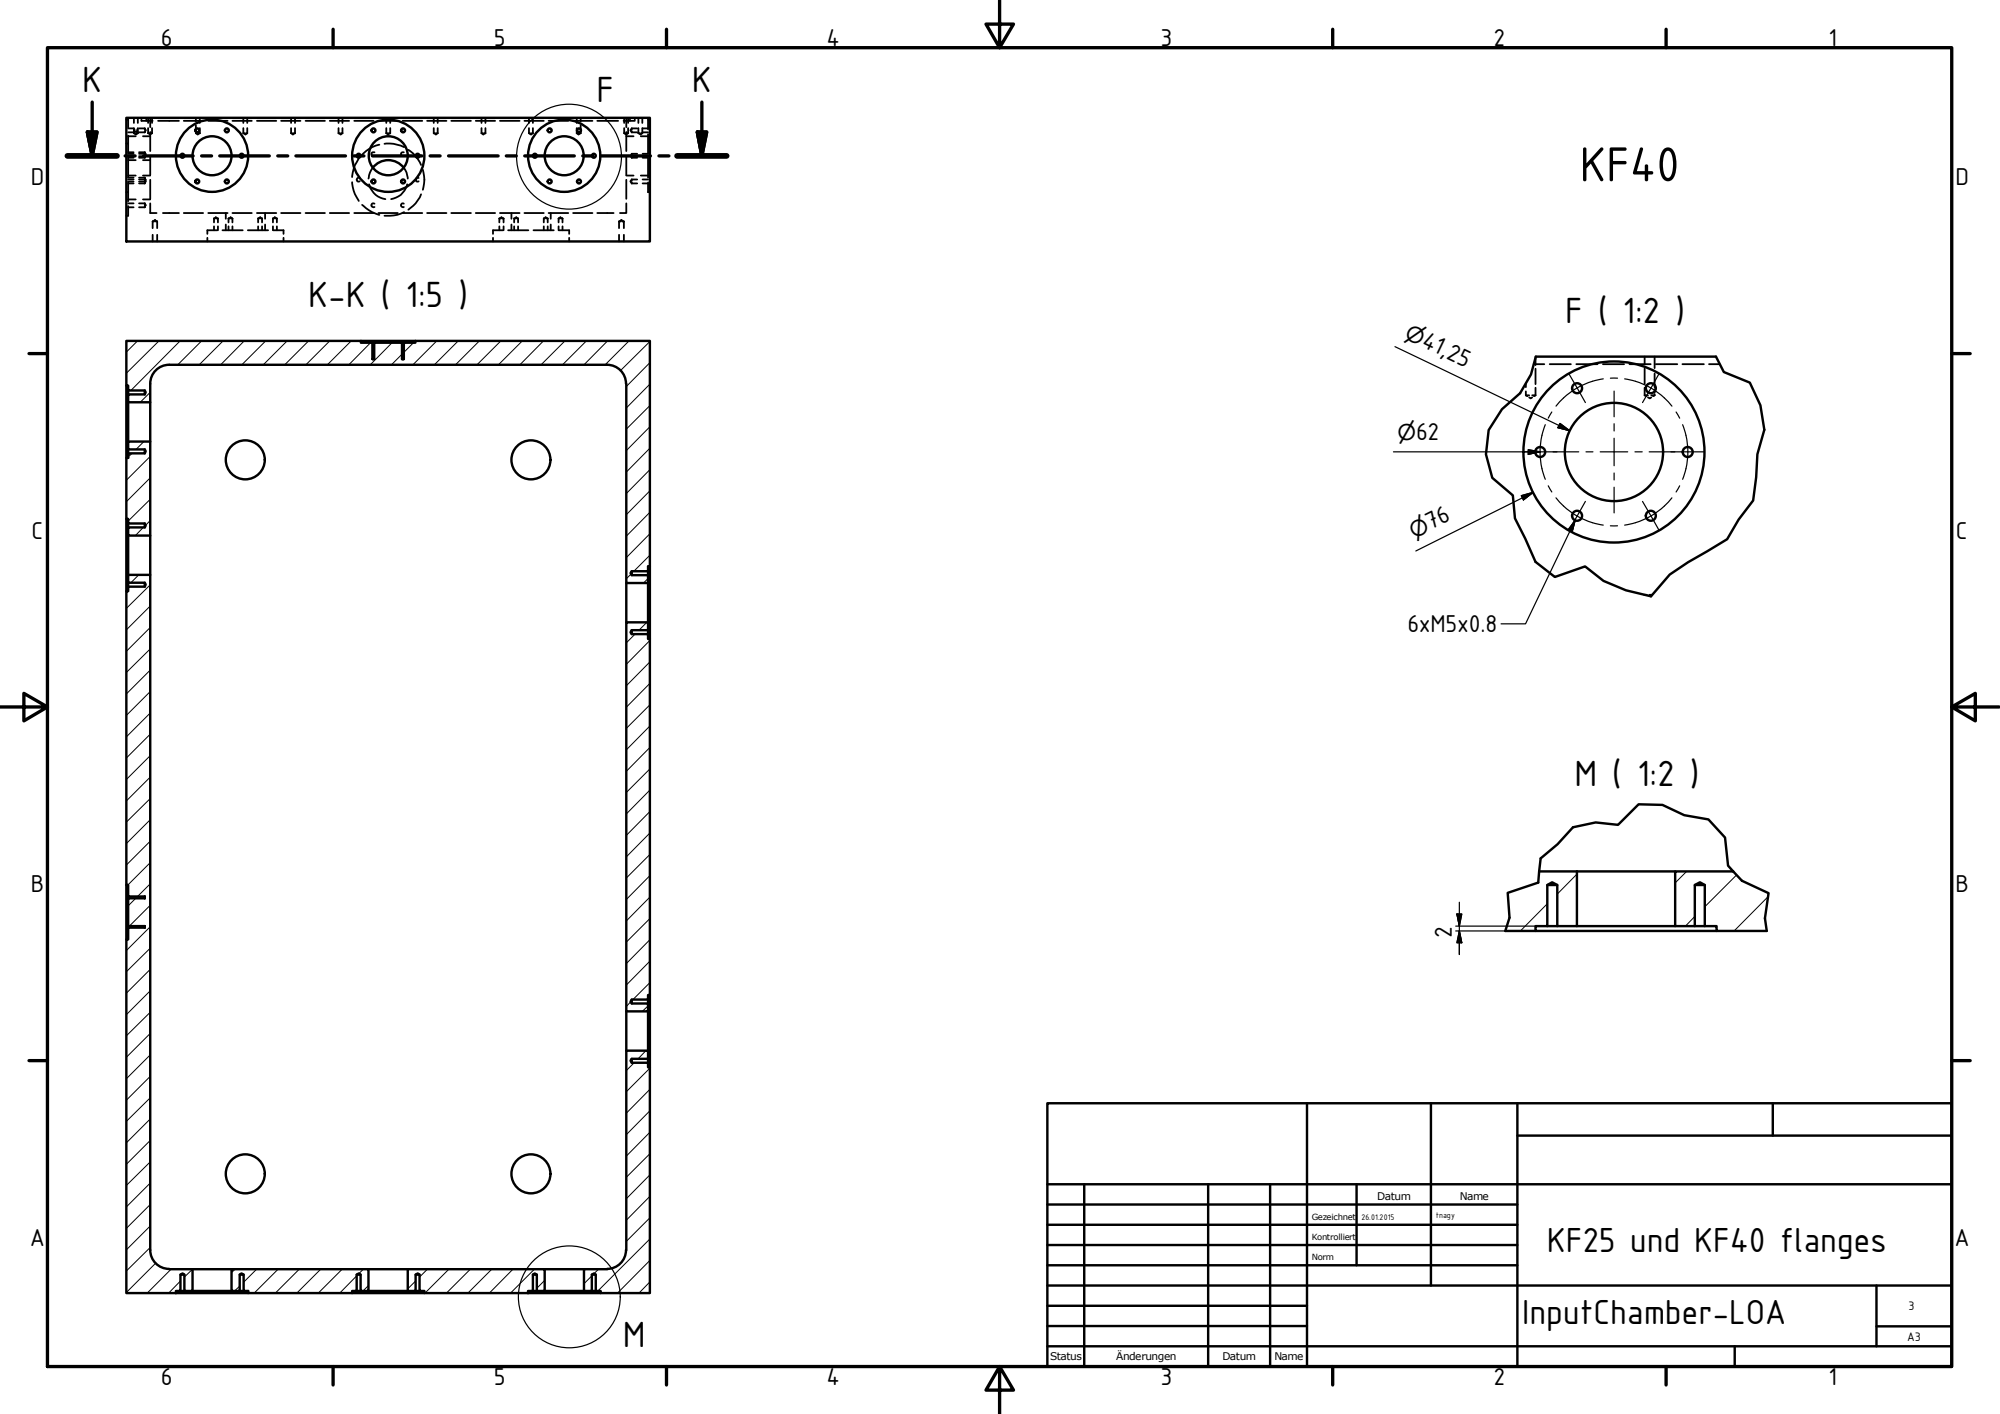
[picture p18: page 1]
InputChamber-LOA; Status; bnderungen; Datum; Name; Gezeichnet; Kontrolliert; Norm; tnagy; KF25 und KF40 flanges
