aline-vernier/octo-laser/HCF/HCF Chambers Tamas/WindowMount-Inner-LOA.pdf

A ( 1 : 1 )

B-B ( 1 : 1 )

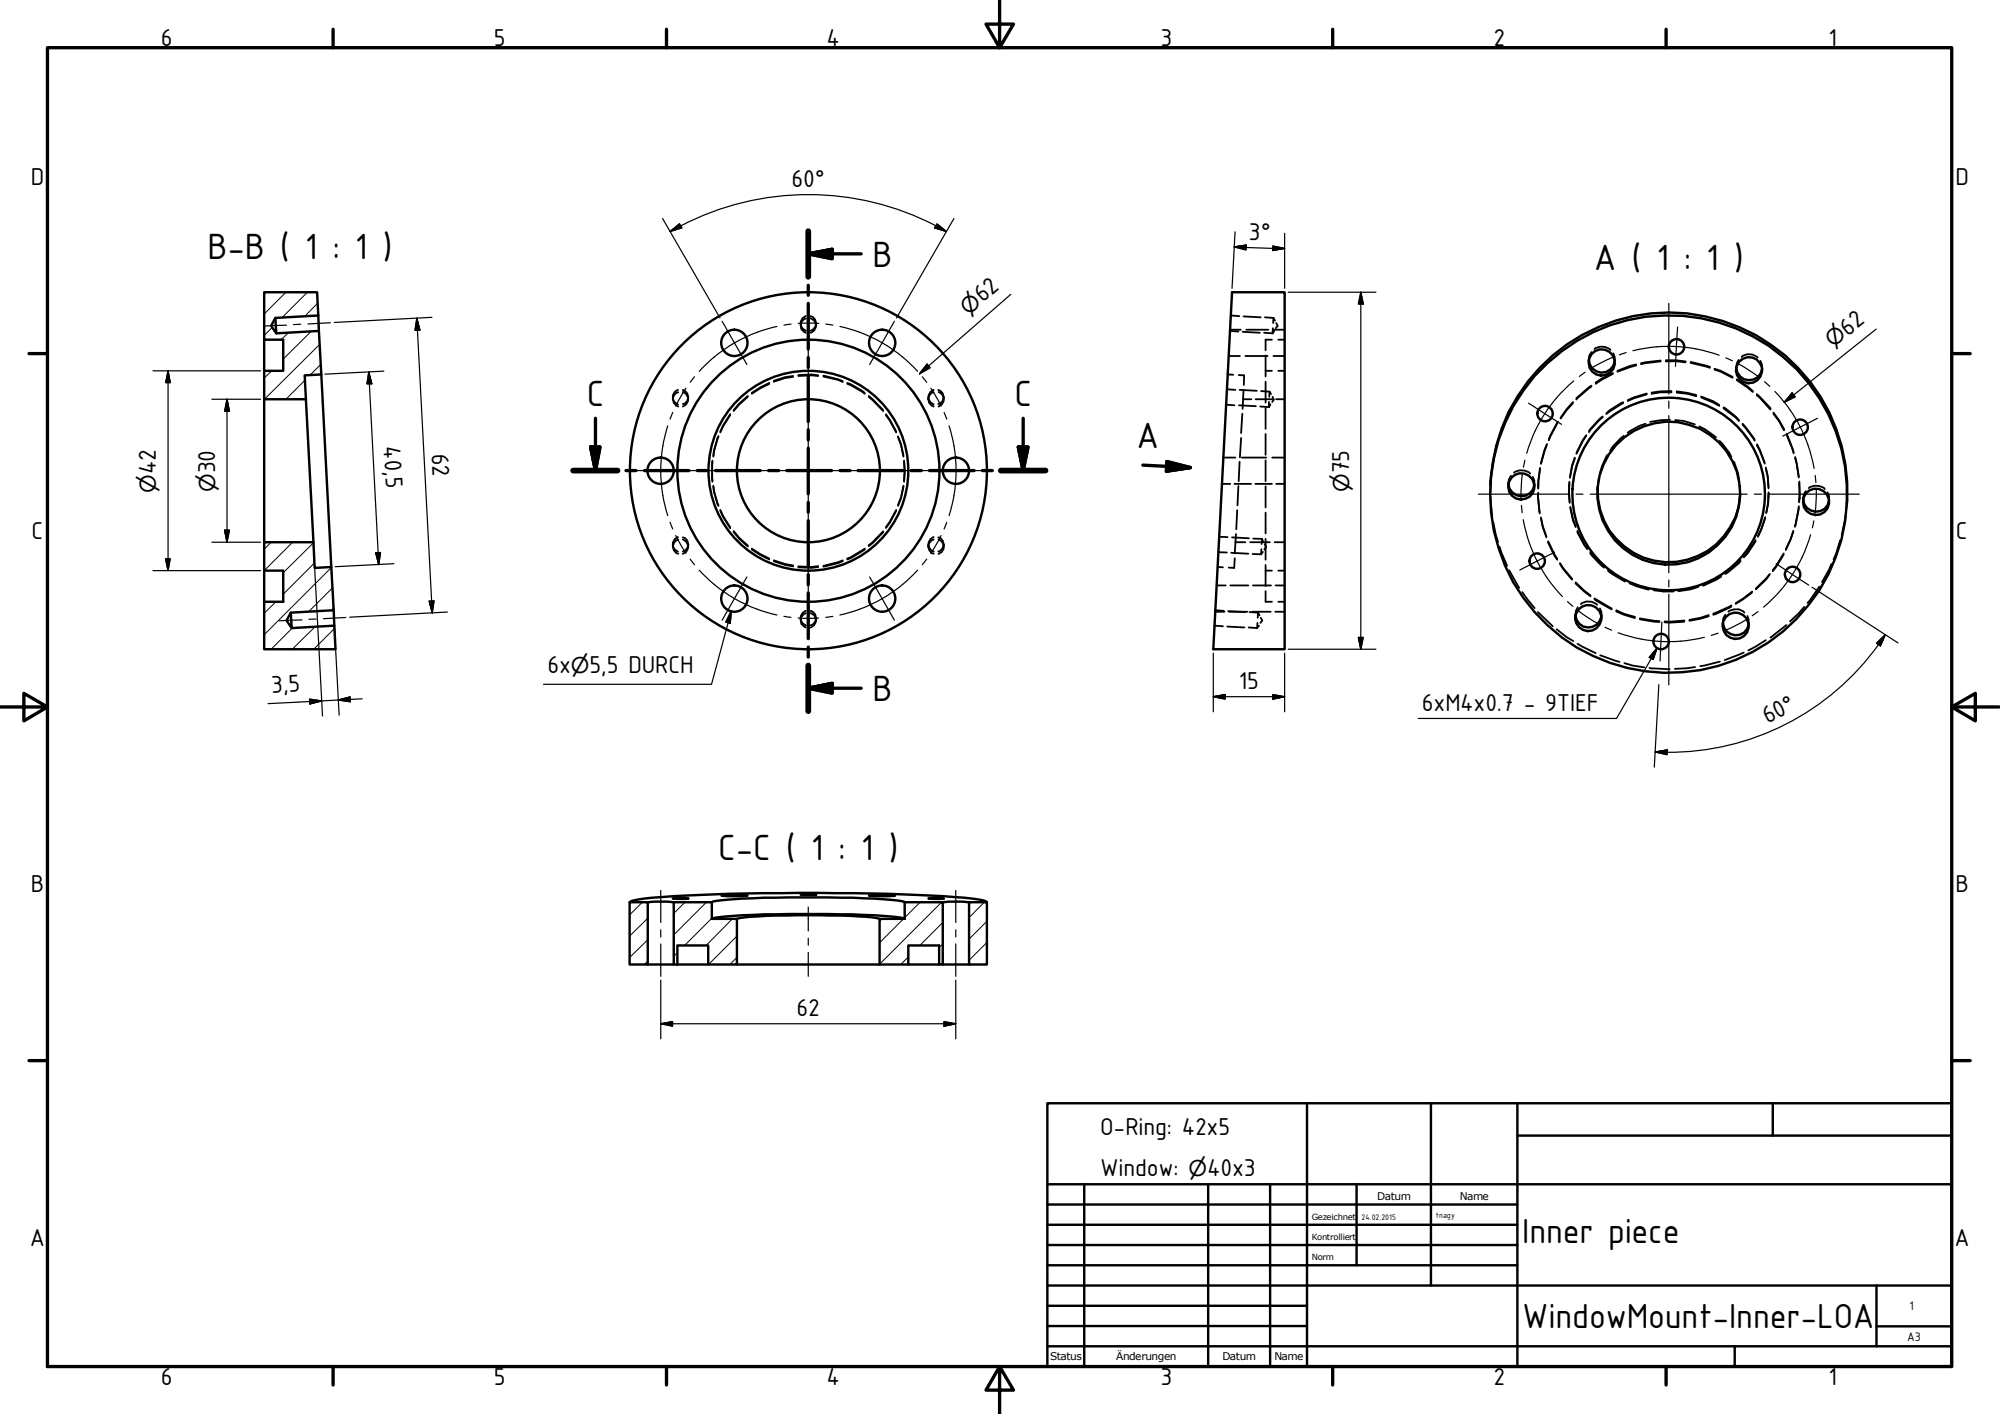
[picture p19: page 1]
Inner piece; Status; bnderungen; Datum; Name; Gezeichnet; Kontrolliert; Norm; tnagy; 6xM4x0.7 - 9TIEF; 6xP5,5 DURCH; O-Ring: 42x5 Window: P40x3

WindowMount-Inner-LOA
