aline-vernier/octo-laser/HCF/HCF Chambers Tamas/WindowMount-Outer-LOA.pdf

A ( 1 : 1 )

B-B ( 1 : 1 )

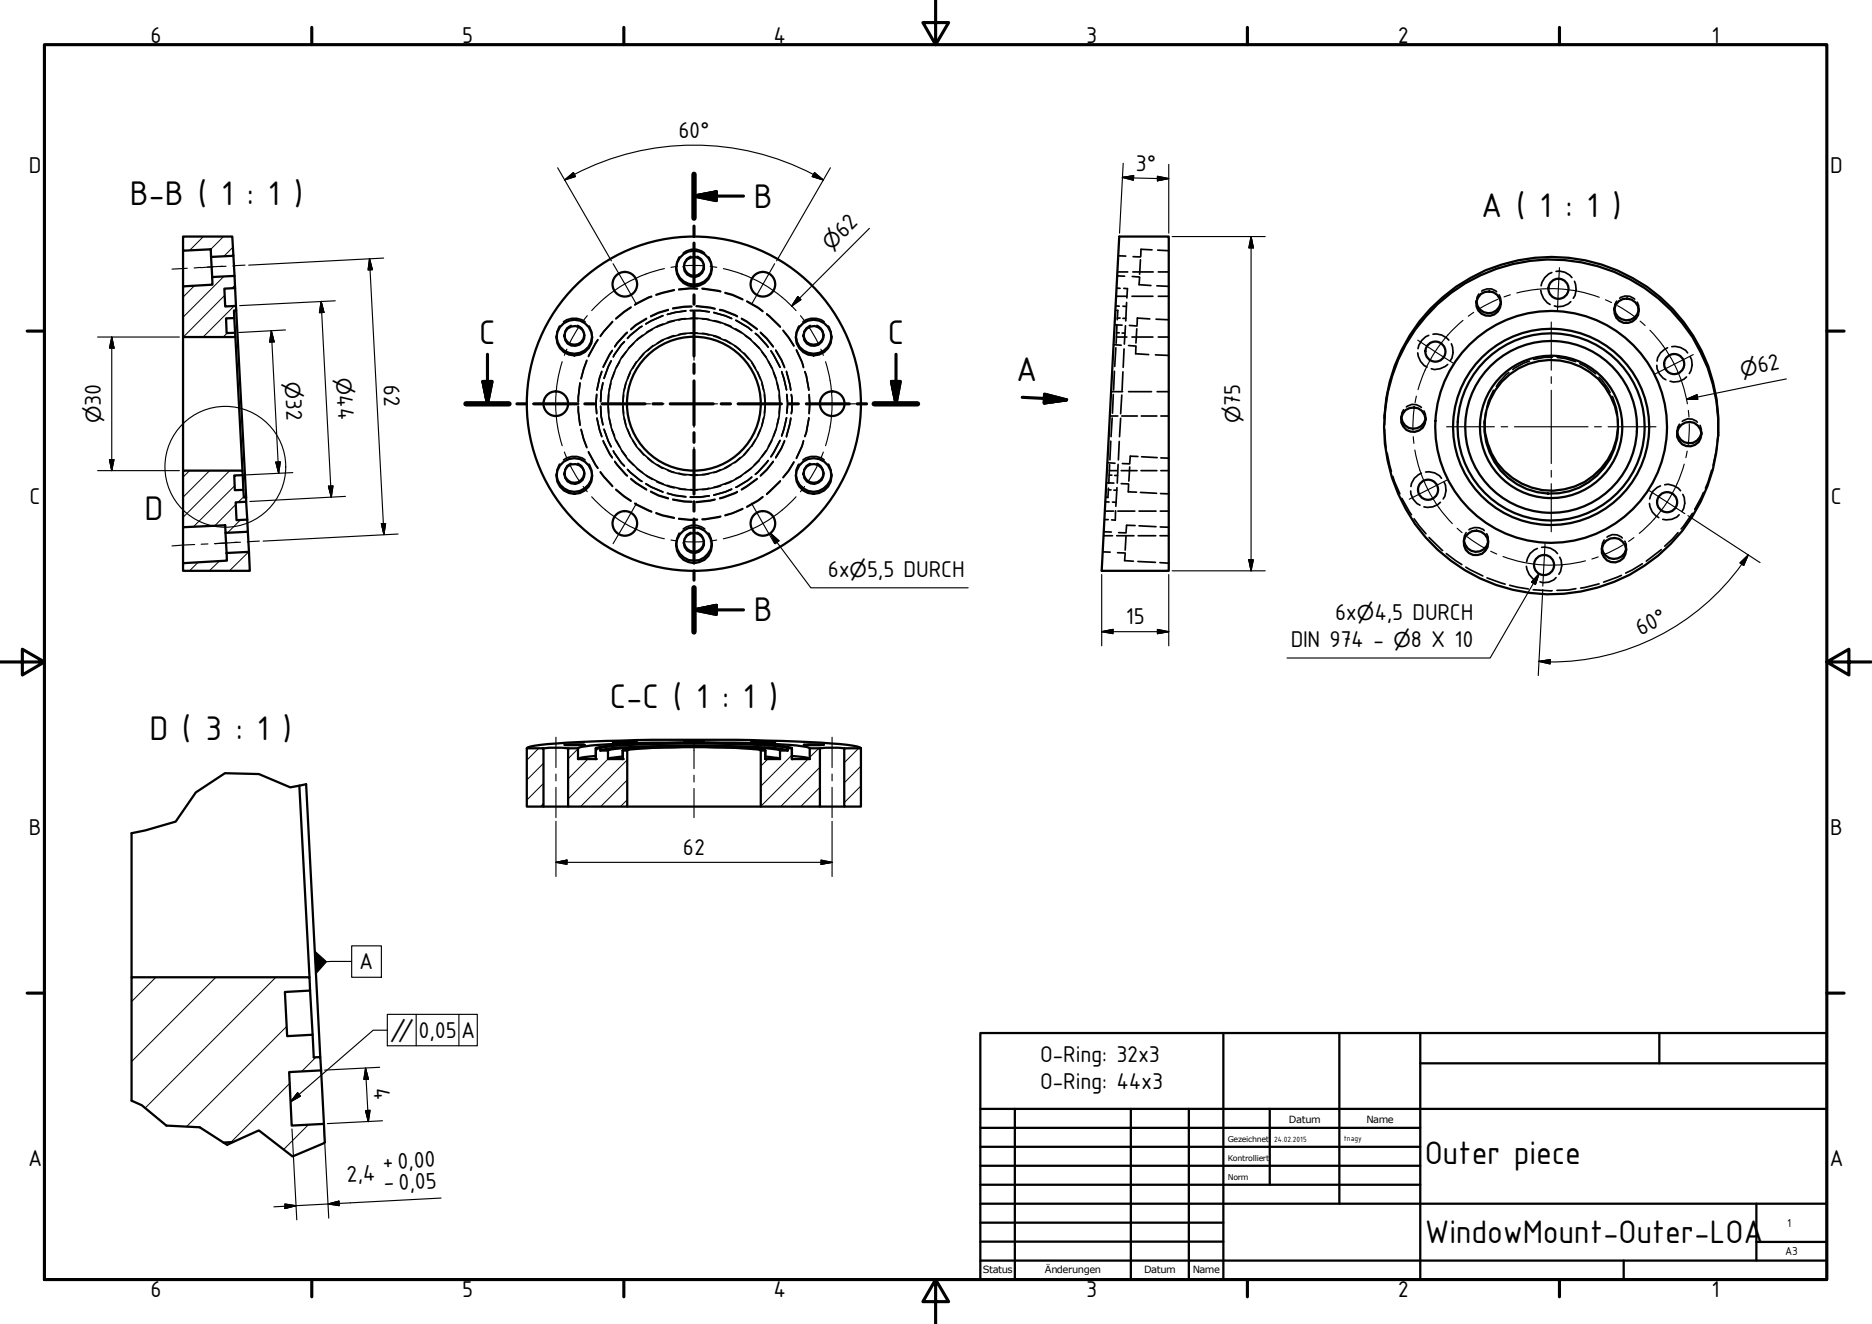
[picture p20: page 1]
Outer piece; Status; bnderungen; Datum; Name; Gezeichnet; Kontrolliert; Norm; tnagy; 6xP5,5 DURCH; 6xP4,5 DURCH DIN 974 - P8 X 10; O-Ring: 32x3 O-Ring: 44x3

WindowMount-Outer-LOA
