aline-vernier/octo-laser/(commit log)

2014-10-06 Added first drawings for compression chamber
    [ILAO40.stp]
2014-10-06 Problèmes d'encombrement en cours de résolution!
2014-10-07 Added real mirror mounts for 1.5" chirped mirrors
2014-10-08 Problem with the inner dimensions of the compression chamber
2014-10-08 Corrected inner size of chamber and size of beams
2014-10-09 Added Deformable mirror. A custom mount might have to be made for a 3" mirror mount.
2014-10-09 Changed design to solve conflict. To be polished, distances for Pump-probe synch to be checked.
2014-10-10 Worked out probe beam delay path. Seems to be ok. One question left: In this configuration, the probe beam also has pulse front tilt.
2014-10-16 Checked mirror mount sizes - Used Thorlabs CAD
2014-10-17 Added setup with holy mirror - Quite different from pellicle setup.
    [Shutter.FCStd]
2014-10-27 Two level Chirped Mirror Assembly
2014-11-17 HCF Incoupling and Outcoupling Chamber
2014-11-18 3 chamber HCF design
2014-12-04 HCF Incoupling Chamber
2014-12-04 Integration of all devices into chamber with stacked chirped mirrors
2014-12-05 Second version of compression chamber with only 1 attenuator and a reflective pellicle as a second attenuator
2015-01-15 One translation stage for prepulse
2015-01-15 added xls files
    [Grandissements.xlsx, liste Matos.xlsx, tailles des pieds.xlsx]
2015-01-15 Adding magnification
    [Grandissements.xlsx, liste Matos.xlsx]
2015-01-27 Periscope ok, motors ok, only problem left : HeNe...
2015-01-28 Purchase List Added
    [Purchase List.xlsx]
2015-01-28 Added changes to Purchase List.xlsx
    [Purchase List.xlsx]
2015-01-29 Updated purchase list
    [Purchase List.xlsx]
2015-02-04 Quotes Requested
    [Purchase List.xlsx]
2015-03-12 Status on 12/03/2015
    [Purchase List.xlsx]
2015-03-13 Tamas chamber drawings included Holed mirror translation at 45deg
2015-03-13 Purchase List updated
    [Purchase List.xlsx]
2015-03-13 Checked Purchase List.xlsx
    [Purchase List.xlsx]
2015-03-18 Updated Purchase List.xlsx
    [Purchase List.xlsx]
2015-04-15 update purchase list
    [Purchase List.xlsx]
2015-04-16 updating list
    [Purchase List.xlsx]
2015-04-17 minor changes
    [Purchase List.xlsx]
2015-06-09 Adding 1.5" mirror mount pdf
2015-06-09 Base plates for chirped mirrors. To be re-checked for possible mistakes
2015-10-27 Compression chamber included
2017-08-15 Tamas drawings and other previous sketches
    [LLG-2014-11-19_collimation.xlsx]
2017-08-15 Compression chamber for thesis
2017-08-15 Compression Chamber with annotations
2017-08-15 Cleanup 2
    [ILAO40.stp, Shutter.FCStd]
2017-08-15 Comp Chamber version for Thesis
